bodri/smuk/hardware/pcb/production/bom.csv

Designator | Footprint | Quantity | Value | LCSC Part #
C1, C2, C4, C5 | 0805 | 4 | 100nF
C10, C9 | 0805 | 2 | 100n
C11, C12 | C_Elec_10x10.2 | 2 | 100u
C13, C14 | CP_EIA-6032-28_Kemet-C | 2 | 10u
C6 | 1206 | 1 | 15p
C7 | 0805 | 1 | 15p
C8 | 1206 | 1 | 100n
D1, D4 | SOT-23 | 2 | MMBD4148SE
D2, D3 | D_SOD-123 | 2 | 1N4148W
D5, D6 | D_SMC | 2 | SK84
HS1 | Heatsink_Fischer_SK96-84SA_2Fixations | 1 | Heatsink_Pad
J1, J3, J4 | Molex_KK-396_A-41791-0003_1x03_P3.96mm_Vertical | 3 | Conn_01x03
J2 | PinHeader_1x09_P2.54mm_Horizontal | 1 | Conn_01x09_Pin
Q1 | SOT-23 | 1 | MMBTA06
Q2 | SOT-23 | 1 | MMBTA56
Q3 | TO-220-3_Vertical | 1 | TIP42
Q4 | TO-220-3_Vertical | 1 | TIP41
R1 | 0805 | 1 | 2K74
R10, R9 | 1206 | 2 | 1K
R11, R12, R2, R5 | 0805 | 4 | 10K
R13 | 0805 | 1 | 1K
R14 | 0805 | 1 | 5K11
R15, R16 | 0805 | 2 | 20
R17, R18 | 0805 | 2 | 200
R19, R22 | 0805 | 2 | 300
R20, R21 | 2512 | 2 | 1K
R23, R24 | 0805 | 2 | 100
R25, R26 | 2512 | 2 | 1
R3 | 0805 | 1 | 15K
R4 | 0805 | 1 | 24K9
R7 | 0805 | 1 | 100K
R8 | 0805 | 1 | 50K
TP1 | TestPoint_Loop_D1.80mm_Drill1.0mm_Beaded | 1 | GND
TP2 | TestPoint_Loop_D1.80mm_Drill1.0mm_Beaded | 1 | FORCE
U1 | TSSOP-14_4.4x5mm_P0.65mm | 1 | OPA4992
U2 | SOT-23 | 1 | TL431DBZ
U3 | TSSOP-16_4.4x5mm_P0.65mm | 1 | CD4053B
U4, U5 | SOIC-8_3.9x4.9mm_P1.27mm | 2 | LM334M
