bodri/smuk/hardware/sense/production/bom.csv

Designator | Footprint | Quantity | Value | LCSC Part #
C1, C2 | C_Elec_10x10.2 | 2 | 100u
C10, C11, C12, C13, C17, C21, C30, C31, C33, C34, C35, C36, C37, C38, C41, C44, C48, C5, C50, C52, C54, C55, C56, C6, C64, C65, C7, C8, C9 | 0603 | 29 | 100n
C14, C19, C22 | 0603 | 3 | 10n
C15, C16, C70, C71 | 1210 | 4 | 10u
C18, C23, C39, C40, C45, C47, C49 | 0603 | 7 | 1u
C20 | 1206 | 1 | 10u
C24, C25 | 0805 | 2 | 10u
C26, C29 | 0603 | 2 | 12p
C27, C32 | 0603 | 2 | 2.2u
C28 | 0603 | 1 | 4.7u
C3 | CP_EIA-6032-28_Kemet-C | 1 | 22u
C4 | 0603 | 1 | 680p
C42, C43, C46 | 0603 | 3 | 1n
C51 | 0603 | 1 | 220n
C53 | 0603 | 1 | 10u
C57, C58 | 0603 | 2 | 100p
C59, C60 | 0603 | 2 | 500p
C61, C62 | 0603 | 2 | 100nF
C63 | 0603 | 1 | 15p
C66 | 1206 | 1 | 15p
C67, C68, C69 | 1206 | 3 | 100n
D1 | SOT-23 | 1 | BAV70
D10, D11, D7, D8 | D_SOD-123 | 4 | 1N4148W
D12, D9 | SOT-23 | 2 | MMBD4148SE
D13, D14 | D_SMC | 2 | SK84
D2 | D_MiniMELF | 1 | BZV55B10
D3, D4, D5, D6 | 0603 | 4 | LED
FB1 | 0603 | 1 | 1K @ 100MHz
FB2, FB3 | 0603 | 2 | FerriteBead_Small
HS1 | Heatsink_Fischer_SK96-84SA_2Fixations | 1 | Heatsink_Pad
J1 | Molex_KK-396_A-41791-0003_1x03_P3.96mm_Vertical | 1 | Conn_01x03_Pin
J2 | Molex_KK-396_A-41791-0005_1x05_P3.96mm_Vertical | 1 | Conn_01x05_Male
J3 | Molex_KK-254_AE-6410-05A_1x05_P2.54mm_Vertical | 1 | Conn_01x05_Pin
JP1, JP2, JP3, JP4, JP7, JP8 | TestPoint_2Pads_Pitch2.54mm_Drill0.8mm | 6 | Jumper_2_Open
K1 | Relay_DPDT_Panasonic_DS2_S | 1 | DS2-S
K2 | Relay_StandexMeder_DIP_LowProfile | 1 | D32A2110
Q1 | SOT-23 | 1 | BC847
Q10, Q14, Q18, Q2, Q3, Q4 | SOT-23 | 6 | 2N7002
Q11, Q12, Q13, Q5, Q6, Q7 | SOT-23 | 6 | ZVN4106F
Q15 | SOT-23 | 1 | BC850
Q16, Q20 | SOT-23 | 2 | MMBTA56
Q17, Q19 | SOT-23 | 2 | MMBTA06
Q21 | TO-220-3_Vertical | 1 | TIP42
Q22 | TO-220-3_Vertical | 1 | TIP41
Q8, Q9 | TSSOP-8_4.4x3mm_P0.65mm | 2 | Si6966DQ
R1 | 0603 | 1 | 2K2
R10, R11, R12, R13, R14, R15, R22, R24, R3, R4 | 0603 | 10 | 1M
R16, R32, R45, R57, R79 | 0603 | 5 | 2K
R17, R18, R19, R20, R21, R35, R98 | 0603 | 7 | 100K
R2 | 1206 | 1 | 330
R23 | 1206 | 1 | 1K8
R25 | 1206 | 1 | 180
R26 | 1206 | 1 | 18
R27 | 1206 | 1 | 1R8
R28, R30, R33, R34, R41, R42, R43, R44, R46, R61, R71, R72, R73, R74, R82 | 0603 | 15 | 1K
R29 | Littelfuse L4CL1206 | 1 | 0R1
R31, R39, R56 | 0603 | 3 | 15K
R36 | 1206 | 1 | 10M
R37, R40, R47, R48, R55, R63, R64, R65, R66, R67, R68, R69, R70, R75, R76, R81 | 0603 | 16 | 10K
R38 | 0603 | 1 | 2K49
R49 | 0603 | 1 | 35K7
R5, R6, R7, R8, R9 | 0603 | 5 | 330K
R50 | 0603 | 1 | 43K2
R51 | 0603 | 1 | 680R
R52, R53, R54 | 0603 | 3 | 680
R58 | 1206 | 1 | 0
R59, R60, R62 | 0603 | 3 | 49R9
R77, R78 | 1206 | 2 | 1K
R80 | 0603 | 1 | 121
R83 | 1206 | 1 | 5K11
R84, R85 | 1206 | 2 | 2K
R86, R87 | 0805 | 2 | 20
R88, R89 | 0805 | 2 | 200
R90, R93 | 0805 | 2 | 300
R91, R92 | 2512 | 2 | 1K
R94, R95 | 0805 | 2 | 100
R96, R97 | 2512 | 2 | 1
TP1 | TestPoint_Loop_D1.80mm_Drill1.0mm_Beaded | 1 | GND
TP2 | TestPoint_Pad_D1.5mm | 1 | Current meas
TP3 | TestPoint_Pad_D1.5mm | 1 | Voltage meas
TP4 | TestPoint_Pad_D1.5mm | 1 | +1V5
TP5 | TestPoint_Pad_D1.5mm | 1 | +3V
TP6 | TestPoint_Loop_D1.80mm_Drill1.0mm_Beaded | 1 | FORCEI
TP7 | TestPoint_Loop_D1.80mm_Drill1.0mm_Beaded | 1 | FORCEV
U1 | TO-263-3_TabPin2 | 1 | uA7805
U10 | TSSOP-16_4.4x5mm_P0.65mm | 1 | AD5686
U11 | TSSOP-20_4.4x6.5mm_P0.65mm | 1 | ADS131M03xPW
U12, U14 | TSSOP-14_4.4x5mm_P0.65mm | 2 | OPA4992
U13 | SOT-23-5 | 1 | REF2030
U15 | TSSOP-16_4.4x5mm_P0.65mm | 1 | CD4053B
U16, U17 | SOIC-8_3.9x4.9mm_P1.27mm | 2 | LM334M
U2 | TSSOP-14_4.4x5mm_P0.65mm | 1 | OPA4189
U3, U5 | SOIC-8_3.9x4.9mm_P1.27mm | 2 | OPA140
U4 | MSOP-8_3x3mm_P0.65mm | 1 | ADG5419BRMZ
U6 | Texas_S-PVSON-N10_ThermalVias | 1 | TPS7A39
U7 | SOT-23-5 | 1 | TPS7A2033DBV
U8 | SOIC-16W_7.5x10.3mm_P1.27mm | 1 | ISO7341C
U9 | QFN-48-1EP_7x7mm_P0.5mm_EP5.6x5.6mm | 1 | STM32H503CBUx
Y1 | Crystal_SMD_SeikoEpson_FA238-4Pin_3.2x2.5mm | 1 | 16MHz
Y2 | CDFN-4_2.5x3.2mm_P2.1mm | 1 | DSC100X
