bodri/smuk/hardware/sense/sense.kicad_pcb

## KiCad design hardware/sense/sense.kicad_pcb (2026-11-12)

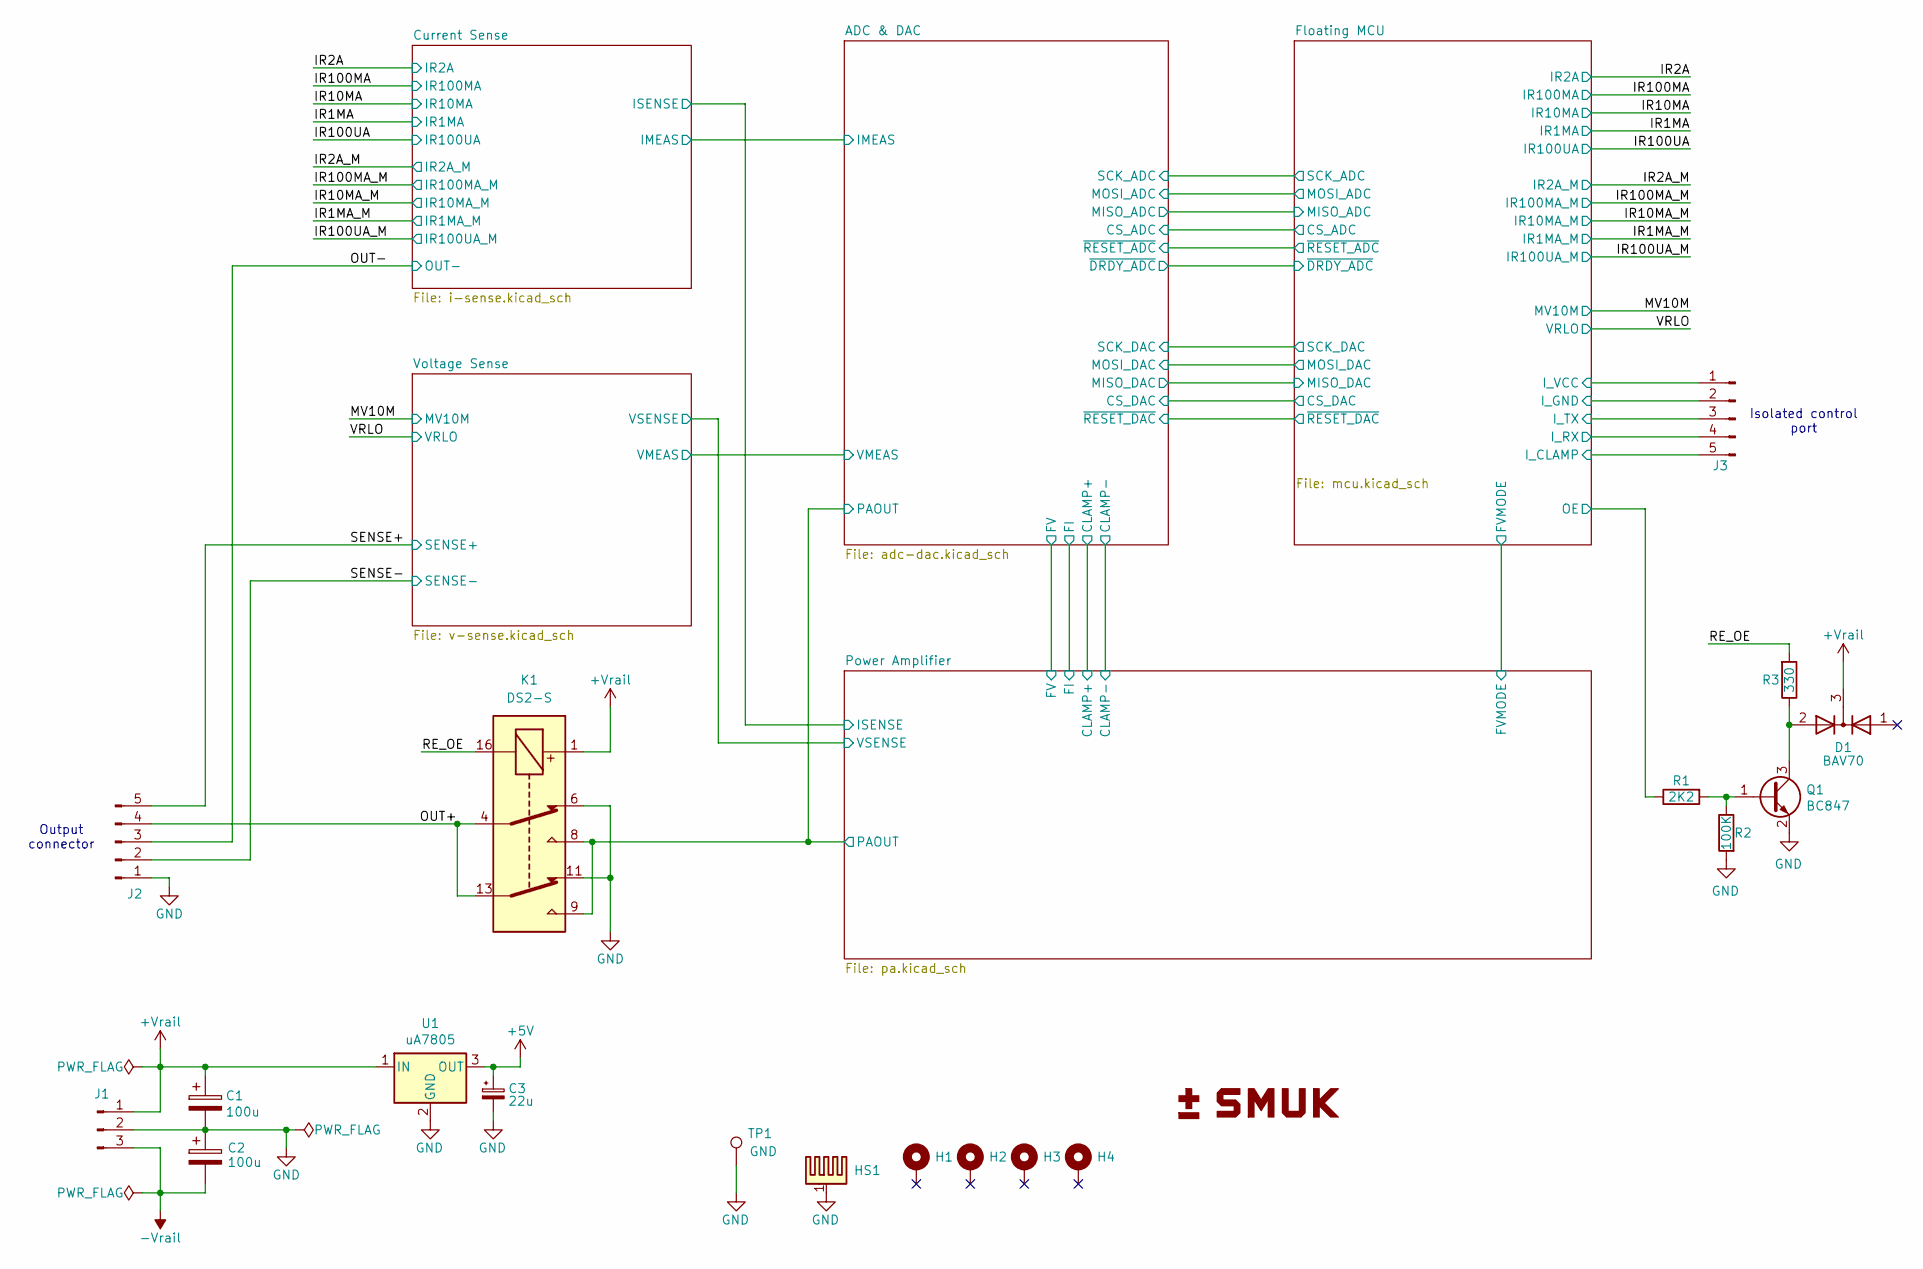
[picture p8: schematic sense.kicad_sch, SMUK (SMU by Kapuki)]

Parts:
C1, C2: 100u; C_Elec_10x10.2
C3: 22u; CP_EIA-6032-28_Kemet-C
D1: BAV70; SOT-23
H1, H2, H3, H4: MountingHole_Pad_MP; MountingHole_3.2mm_M3_Pad_Via
HS1: Heatsink_Pad; Heatsink_Fischer_SK96-84SA_2Fixations
J1: Conn_01x03_Pin; Molex_KK-396_A-41791-0003_1x03_P3.96mm_Vertical
J2: Conn_01x05_Male; Molex_KK-396_A-41791-0005_1x05_P3.96mm_Vertical
J3: Conn_01x05_Pin; Molex_KK-254_AE-6410-05A_1x05_P2.54mm_Vertical
K1: DS2-S; Relay_DPDT_Panasonic_DS2_S
Q1: BC847; SOT-23
R1: 2K2; R_0603_1608Metric
R2: 100K; R_0603_1608Metric
R3: 330; R_1206_3216Metric
TP1: GND; TestPoint_Loop_D1.80mm_Drill1.0mm_Beaded
U1: uA7805; TO-263-3_TabPin2

Connections:
+5V: C3.1, U1.3 (OUT); also elsewhere on the board
+Vrail: C1.1, D1.3 (K), J1.1, K1.1, U1.1 (IN); also elsewhere on the board
-Vrail: C2.2, J1.3; also elsewhere on the board
/ADC & DAC/PAOUT: K1.8, K1.9; also elsewhere on the board
/Floating MCU/I_CLAMP: J3.5; also elsewhere on the board
/Floating MCU/I_GND: J3.2; also elsewhere on the board
/Floating MCU/I_RX: J3.4; also elsewhere on the board
/Floating MCU/I_TX: J3.3; also elsewhere on the board
/Floating MCU/I_VCC: J3.1; also elsewhere on the board
/Floating MCU/OE: R1.1; also elsewhere on the board
/OUT+: J2.4, K1.4, K1.13
/OUT-: J2.3; also elsewhere on the board
/RE_OE: K1.16, R3.2
/SENSE+: J2.5; also elsewhere on the board
/SENSE-: J2.2; also elsewhere on the board
GND: C1.2, C2.1, C3.2, HS1.1, J1.2, J2.1, K1.6, K1.11, Q1.2 (E), R2.2, TP1.1 (1_1), U1.2 (GND); also elsewhere on the board
unnamed: Q1.1 (B), R1.2, R2.1
unnamed: D1.2 (A), Q1.3 (C), R3.1

Notes on the sheet:
Isolated control port
Output connector

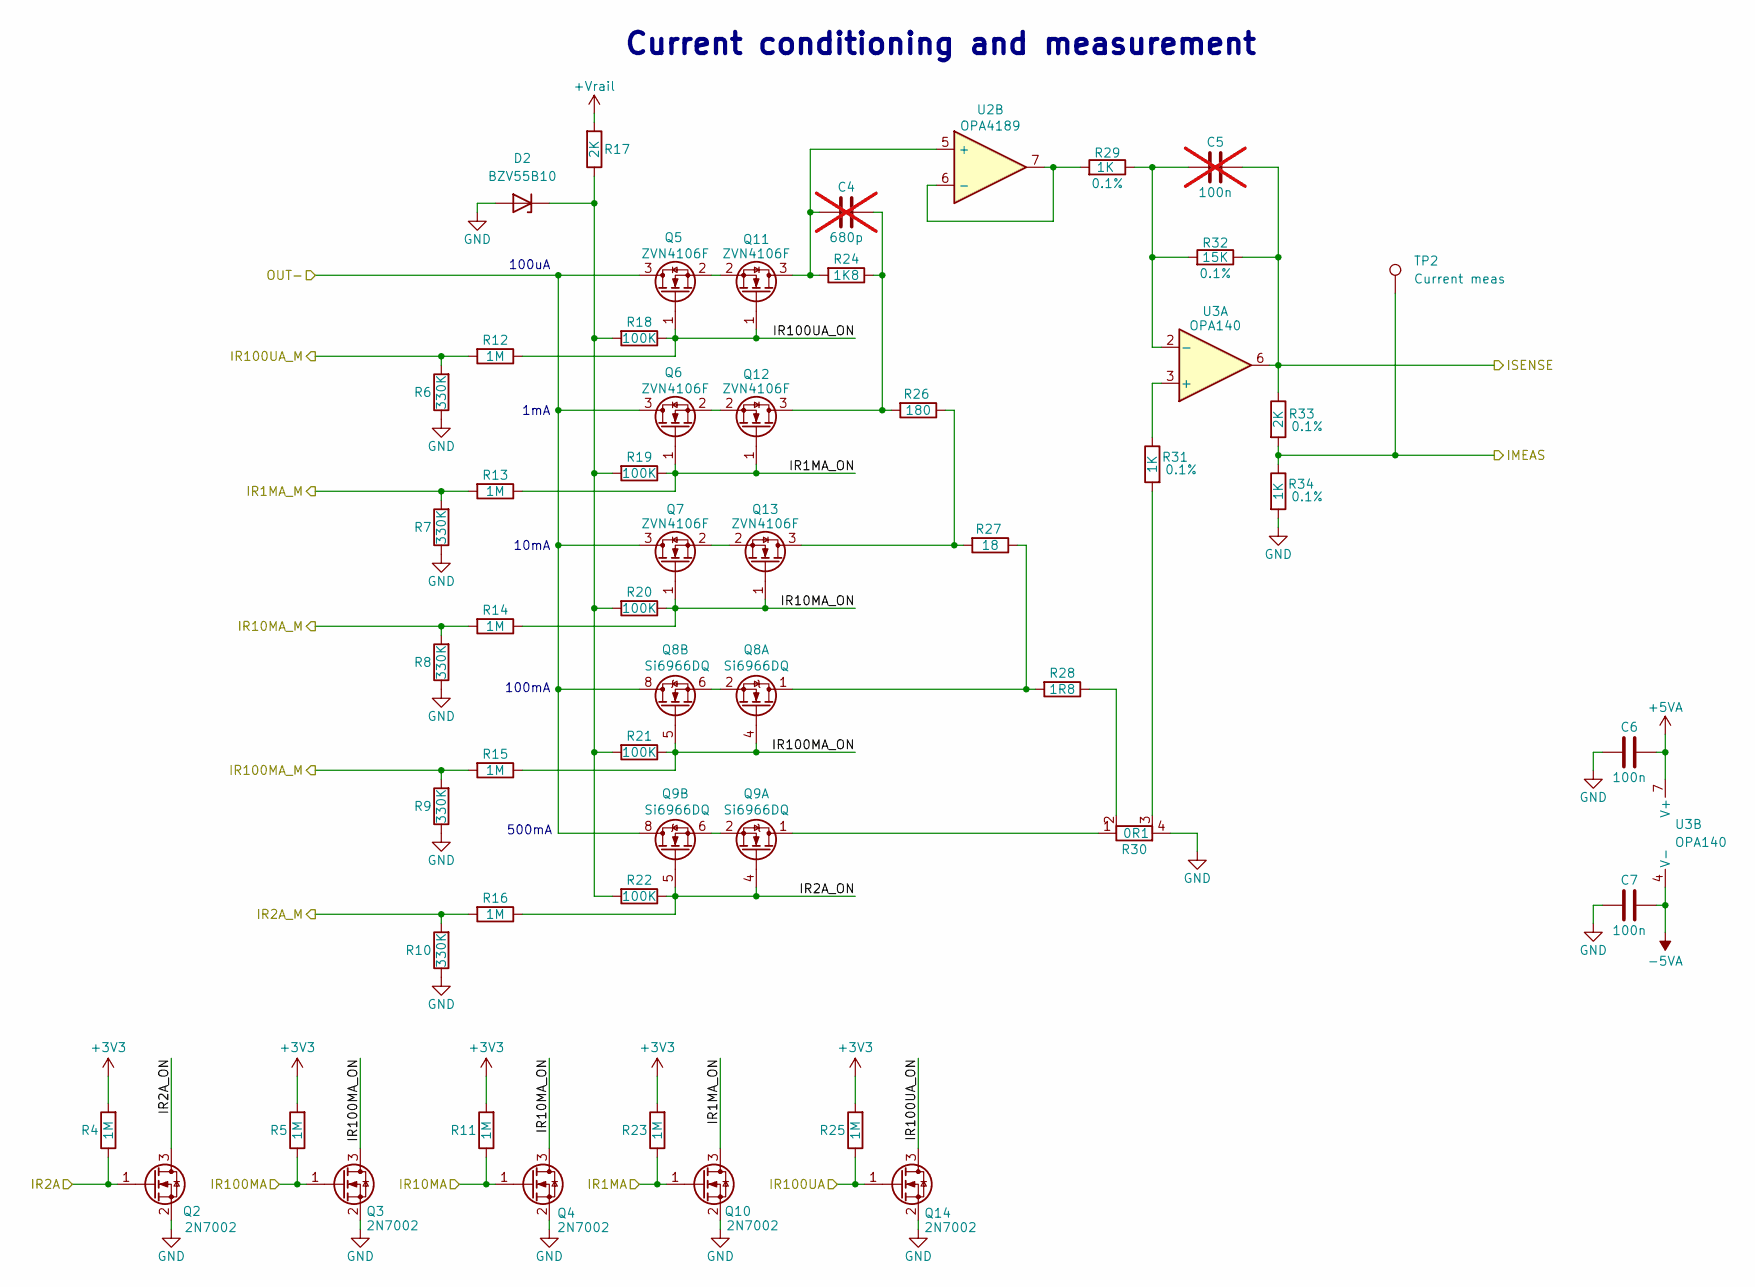
[picture p9: schematic i-sense.kicad_sch, SMUK (SMU by Kapuki)]

Parts:
C4: 680p; C_0603_1608Metric; not fitted
C5: 100n; C_0603_1608Metric; not fitted
C6, C7: 100n; C_0603_1608Metric
D2: BZV55B10; D_MiniMELF
Q2, Q3, Q4, Q10, Q14: 2N7002; SOT-23
Q5, Q6, Q7, Q11, Q12, Q13: ZVN4106F; SOT-23
Q8, Q9: Si6966DQ; TSSOP-8_4.4x3mm_P0.65mm
R4, R5, R11, R12, R13, R14, R15, R16, R23, R25: 1M; R_0603_1608Metric
R6, R7, R8, R9, R10: 330K; R_0603_1608Metric
R17, R33: 2K; R_0603_1608Metric
R18, R19, R20, R21, R22: 100K; R_0603_1608Metric
R24: 1K8; R_1206_3216Metric
R26: 180; R_1206_3216Metric
R27: 18; R_1206_3216Metric
R28: 1R8; R_1206_3216Metric
R29, R31, R34: 1K; R_0603_1608Metric
R30: 0R1; Littelfuse L4CL1206
R32: 15K; R_0603_1608Metric
TP2: Current meas; TestPoint_Pad_D1.5mm
U2: OPA4189; TSSOP-14_4.4x5mm_P0.65mm
U3: OPA140; SOIC-8_3.9x4.9mm_P1.27mm

Connections:
+3V3: R4.2, R5.2, R11.2, R23.2, R25.2; also elsewhere on the board
+5VA: C6.1, U3.7 (V+); also elsewhere on the board
+Vrail: R17.2; also elsewhere on the board
-5VA: C7.1, U3.4 (V-); also elsewhere on the board
/ADC & DAC/IMEAS: R33.2, R34.1, TP2.1 (1_1); also elsewhere on the board
/Current Sense/IR1MA_ON: Q6.1 (G), Q10.3 (D), Q12.1 (G), R13.1, R19.1
/Current Sense/IR2A_ON: Q2.3 (D), Q9.4 (G1), Q9.5 (G2), R16.1, R22.1
/Current Sense/IR10MA_ON: Q4.3 (D), Q7.1 (G), Q13.1 (G), R14.1, R20.1
/Current Sense/IR100MA_ON: Q3.3 (D), Q8.4 (G1), Q8.5 (G2), R15.1, R21.1
/Current Sense/IR100UA_ON: Q5.1 (G), Q11.1 (G), Q14.3 (D), R12.1, R18.1
/Current Sense/ISENSE: C5.1, R32.1, R33.1, U3.6; also elsewhere on the board
/IR1MA: Q10.1 (G), R23.1; also elsewhere on the board
/IR1MA_M: R7.2, R13.2; also elsewhere on the board
/IR2A: Q2.1 (G), R4.1; also elsewhere on the board
/IR2A_M: R10.2, R16.2; also elsewhere on the board
/IR10MA: Q4.1 (G), R11.1; also elsewhere on the board
/IR10MA_M: R8.2, R14.2; also elsewhere on the board
/IR100MA: Q3.1 (G), R5.1; also elsewhere on the board
/IR100MA_M: R9.2, R15.2; also elsewhere on the board
/IR100UA: Q14.1 (G), R25.1; also elsewhere on the board
/IR100UA_M: R6.2, R12.2; also elsewhere on the board
/OUT-: Q5.3 (D), Q6.3 (D), Q7.3 (D), Q8.8 (D2), Q9.8 (D2); also elsewhere on the board
GND: C6.2, C7.2, D2.2 (A), Q2.2 (S), Q3.2 (S), Q4.2 (S), Q10.2 (S), Q14.2 (S), R6.1, R7.1, R8.1, R9.1, R10.1, R30.4, R34.2; also elsewhere on the board
unnamed: D2.1 (K), R17.1, R18.2, R19.2, R20.2, R21.2, R22.2
unnamed: Q8.1 (D1), R27.1, R28.2
unnamed: Q8.2 (S1), Q8.3 (S1), Q8.6 (S2), Q8.7 (S2)
unnamed: Q9.1 (D1), R30.1
unnamed: Q9.2 (S1), Q9.3 (S1), Q9.6 (S2), Q9.7 (S2)
unnamed: C4.2, Q11.3 (D), R24.2, U2.5 (+)
unnamed: Q5.2 (S), Q11.2 (S)
unnamed: C4.1, Q12.3 (D), R24.1, R26.2
unnamed: Q6.2 (S), Q12.2 (S)
unnamed: Q13.3 (D), R26.1, R27.2
unnamed: Q7.2 (S), Q13.2 (S)
unnamed: R28.1, R30.2
unnamed: R30.3, R31.2
unnamed: R29.2, U2.6 (-), U2.7
unnamed: R31.1, U3.3 (+)
unnamed: C5.2, R29.1, R32.2, U3.2 (-)

Notes on the sheet:
100mA
100uA
1mA
500mA
10mA
Current conditioning and measurement

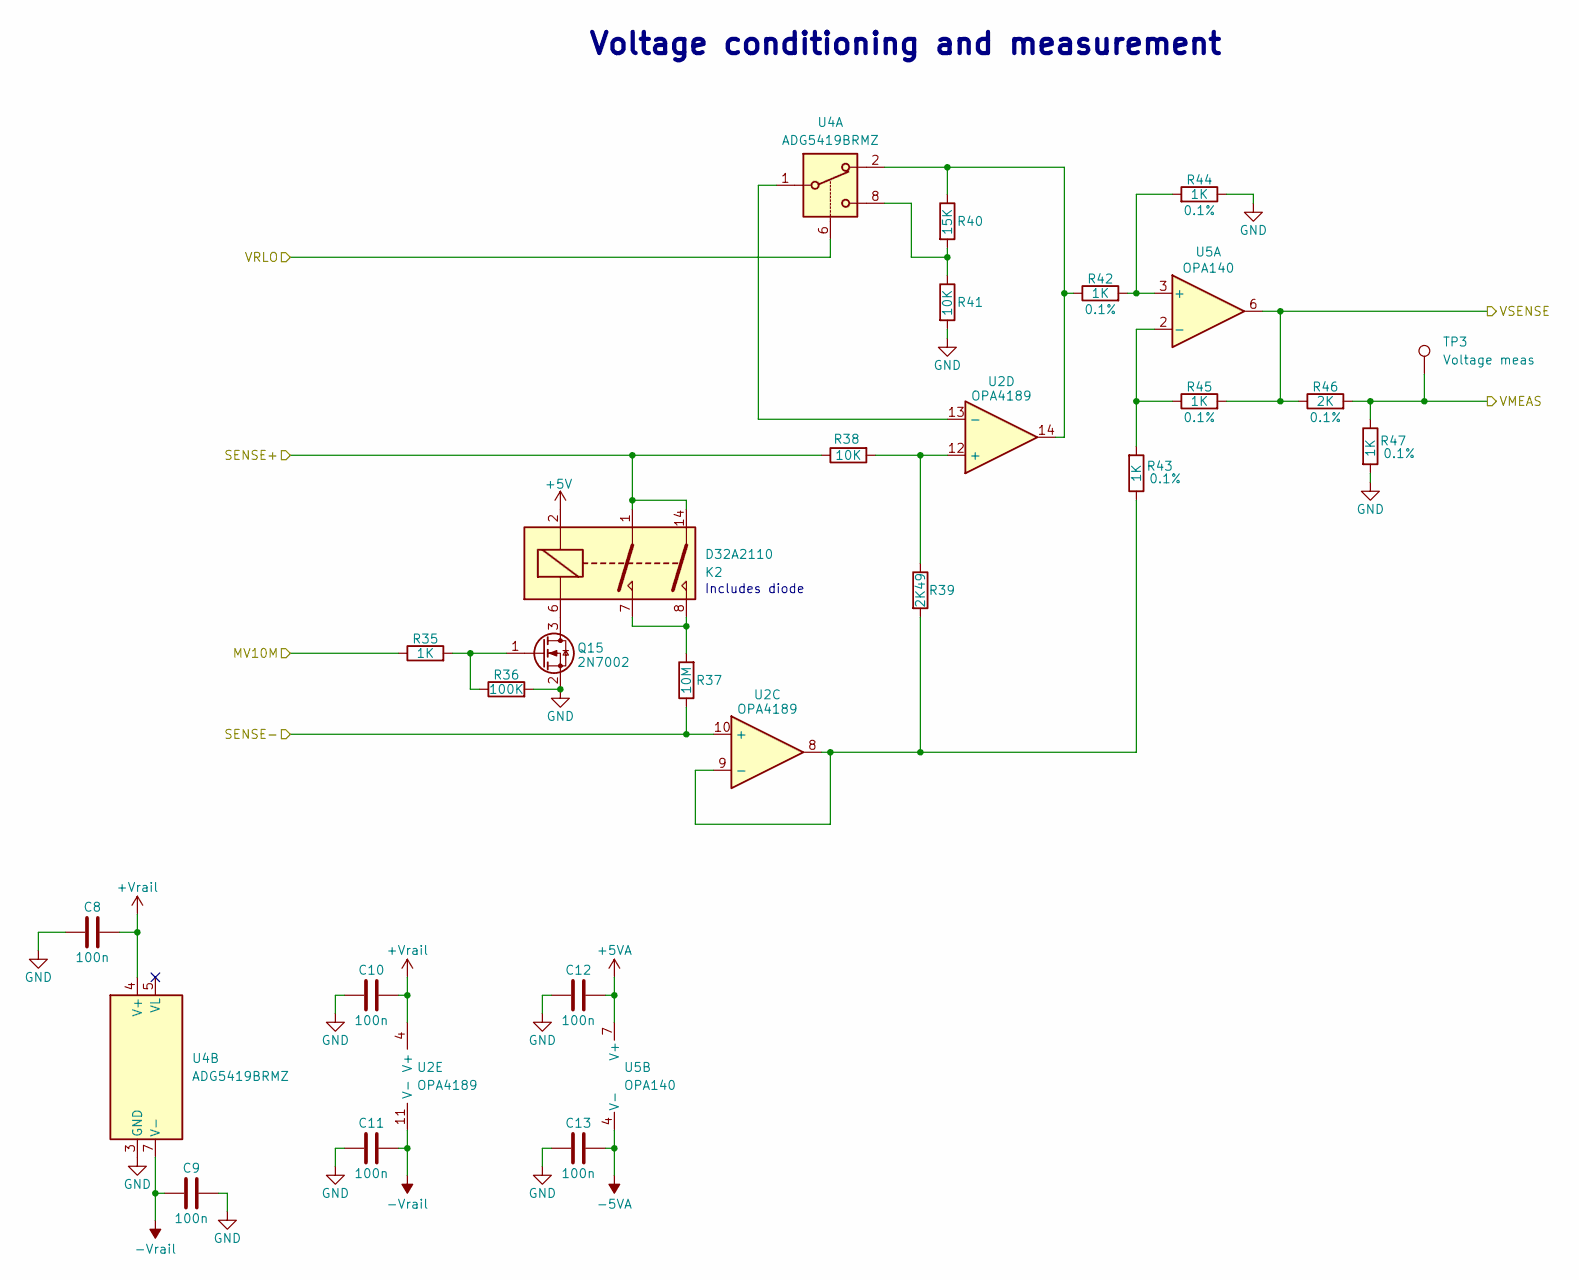
[picture p10: schematic v-sense.kicad_sch, SMUK (SMU by Kapuki)]

Parts:
C8, C9, C10, C11, C12, C13: 100n; C_0603_1608Metric
K2: D32A2110; Relay_StandexMeder_DIP_LowProfile
Q15: 2N7002; SOT-23
R35, R42, R43, R44, R45, R47: 1K; R_0603_1608Metric
R36: 100K; R_0603_1608Metric
R37: 10M; R_1206_3216Metric
R38, R41: 10K; R_0603_1608Metric
R39: 2K49; R_0603_1608Metric
R40: 15K; R_0603_1608Metric
R46: 2K; R_0603_1608Metric
TP3: Voltage meas; TestPoint_Pad_D1.5mm
U2: OPA4189; TSSOP-14_4.4x5mm_P0.65mm
U4: ADG5419BRMZ; MSOP-8_3x3mm_P0.65mm
U5: OPA140; SOIC-8_3.9x4.9mm_P1.27mm

Connections:
+5V: K2.2; also elsewhere on the board
+5VA: C12.1, U5.7 (V+); also elsewhere on the board
+Vrail: C8.1, C10.1, U2.4 (V+), U4.4 (V+); also elsewhere on the board
-5VA: C13.1, U5.4 (V-); also elsewhere on the board
-Vrail: C9.1, C11.1, U2.11 (V-), U4.7 (V-); also elsewhere on the board
/ADC & DAC/VMEAS: R46.2, R47.1, TP3.1 (1_1); also elsewhere on the board
/MV10M: R35.1; also elsewhere on the board
/Power Amplifier/VSENSE: R45.2, R46.1, U5.6; also elsewhere on the board
/SENSE+: K2.1, K2.14, R38.1; also elsewhere on the board
/SENSE-: R37.1, U2.10 (+); also elsewhere on the board
/VRLO: U4.6; also elsewhere on the board
GND: C8.2, C9.2, C10.2, C11.2, C12.2, C13.2, Q15.2 (S), R36.2, R41.2, R44.1, R47.2, U4.3 (GND); also elsewhere on the board
unnamed: K2.7, K2.8, R37.2
unnamed: K2.6, Q15.3 (D)
unnamed: Q15.1 (G), R35.2, R36.1
unnamed: R40.1, R42.1, U2.14, U4.2
unnamed: R40.2, R41.1, U4.8
unnamed: R39.2, R43.1, U2.8, U2.9 (-)
unnamed: R38.2, R39.1, U2.12 (+)
unnamed: U2.13 (-), U4.1
unnamed: R42.2, R44.2, U5.3 (+)
unnamed: R43.2, R45.1, U5.2 (-)

Notes on the sheet:
Voltage conditioning and measurement
Includes diode

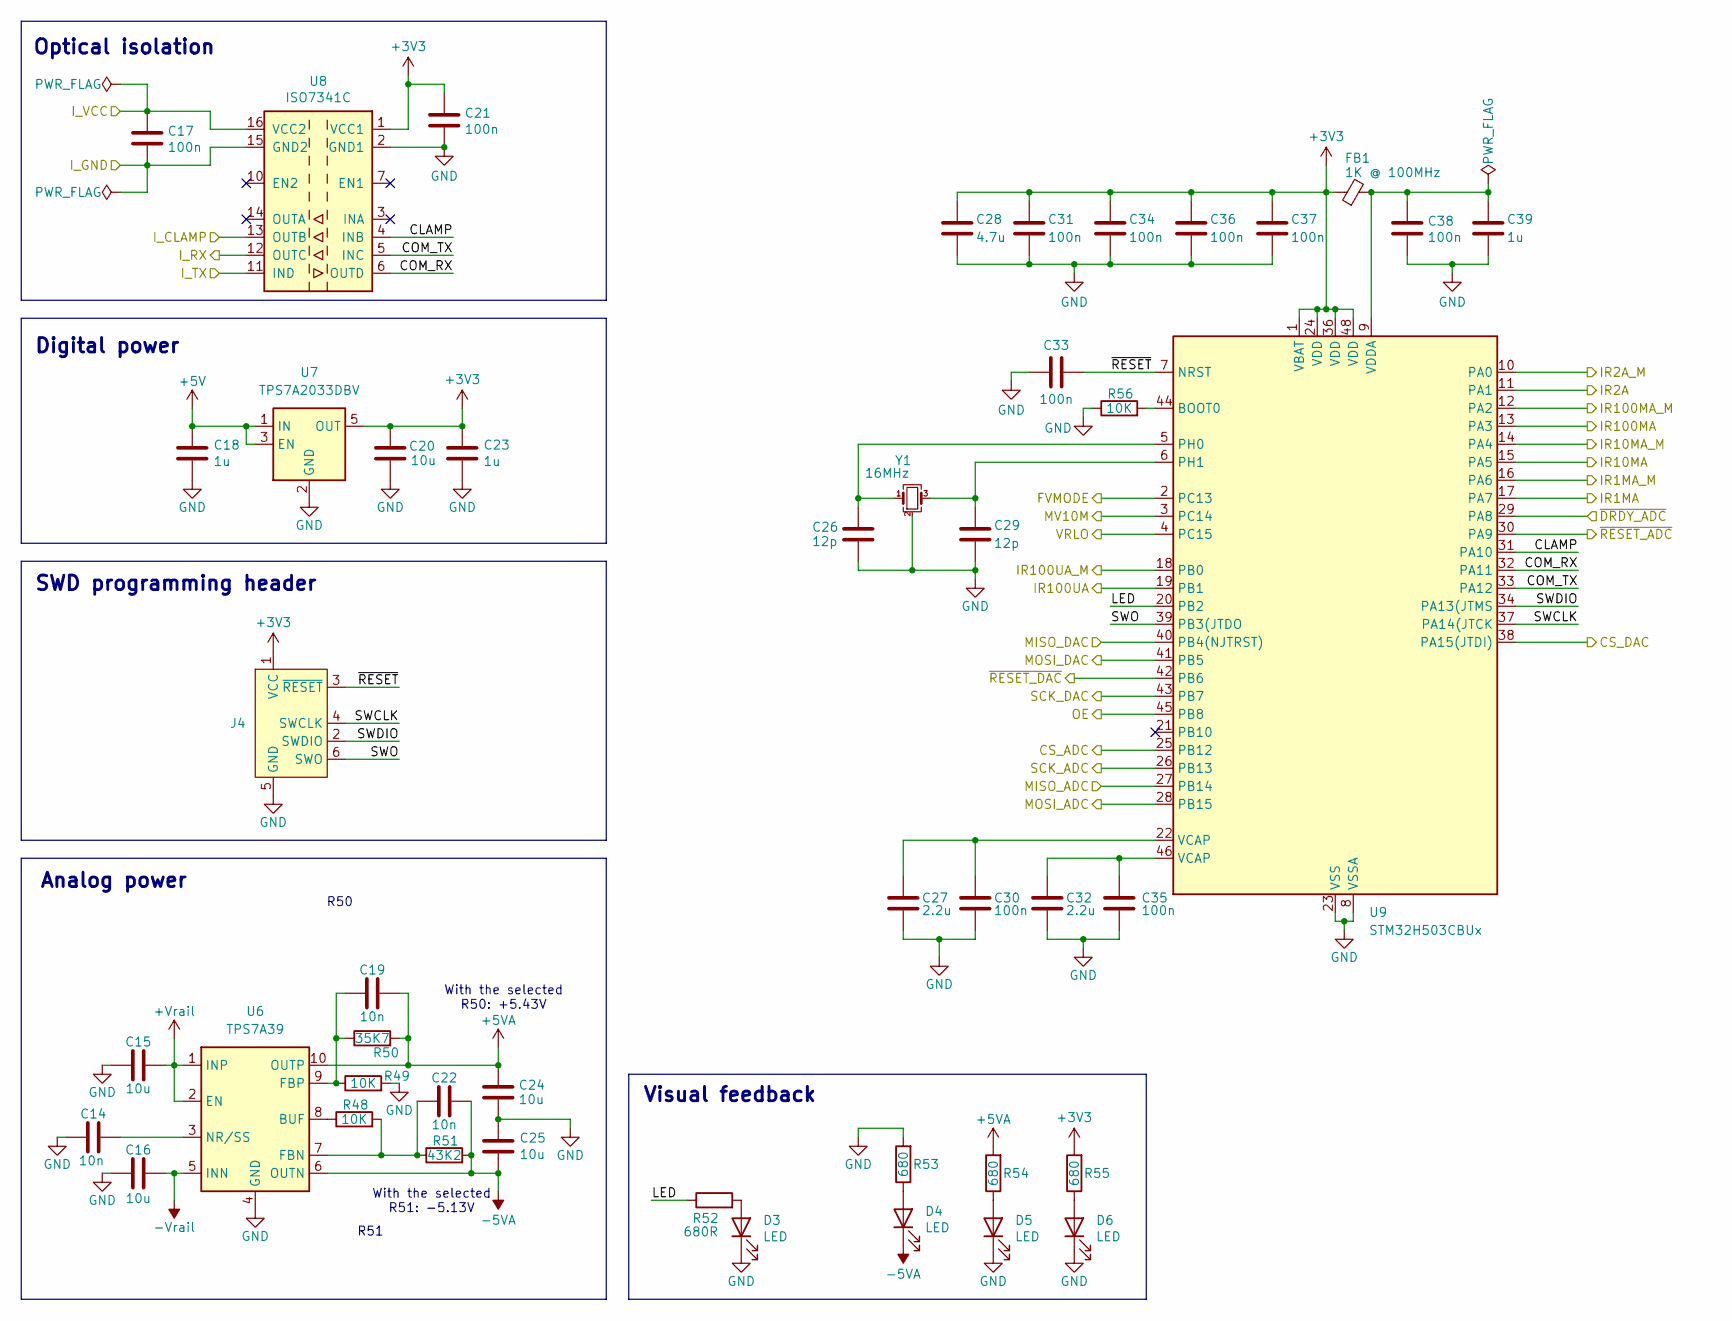
[picture p11: schematic mcu.kicad_sch, SMUK (SMU by Kapuki)]

Parts:
C14, C19, C22: 10n; C_0603_1608Metric
C15, C16: 10u; C_1210_3225Metric
C17, C21, C30, C31, C33, C34, C35, C36, C37, C38: 100n; C_0603_1608Metric
C18, C23, C39: 1u; C_0603_1608Metric
C20: 10u; C_1206_3216Metric
C24, C25: 10u; C_0805_2012Metric
C26, C29: 12p; C_0603_1608Metric
C27, C32: 2.2u; C_0603_1608Metric
C28: 4.7u; C_0603_1608Metric
D3, D4, D5, D6: LED; LED_0603_1608Metric
FB1: 1K @ 100MHz; L_0603_1608Metric
J4: Tag Connector; Tag-Connect_TC2030-IDC-NL_2x03_P1.27mm_Vertical
R48, R49, R56: 10K; R_0603_1608Metric
R50: 35K7; R_0603_1608Metric
R51: 43K2; R_0603_1608Metric
R52: 680R; R_0603_1608Metric
R53, R54, R55: 680; R_0603_1608Metric
U6: TPS7A39; Texas_S-PVSON-N10_ThermalVias
U7: TPS7A2033DBV; SOT-23-5
U8: ISO7341C; SOIC-16W_7.5x10.3mm_P1.27mm
U9: STM32H503CBUx; QFN-48-1EP_7x7mm_P0.5mm_EP5.6x5.6mm
Y1: 16MHz; Crystal_SMD_SeikoEpson_FA238-4Pin_3.2x2.5mm

Connections:
+3V3: C20.1, C21.1, C23.1, C28.1, C31.1, C34.1, C36.1, C37.1, FB1.1, J4.1 (VCC), R55.2, U7.5 (OUT), U8.1 (VCC1), U9.1 (VBAT), U9.24 (VDD), U9.36 (VDD), U9.48 (VDD); also elsewhere on the board
+5V: C18.1, U7.1 (IN), U7.3 (EN); also elsewhere on the board
+5VA: C19.1, C24.1, R50.2, R54.2, U6.10 (OUTP); also elsewhere on the board
+Vrail: C15.1, U6.1 (INP), U6.2 (EN); also elsewhere on the board
-5VA: C22.1, C25.2, D4.1 (K), R51.2, U6.6 (OUTN); also elsewhere on the board
-Vrail: C16.1, U6.5 (INN); also elsewhere on the board
/ADC & DAC/CS_ADC: U9.25 (PB12); also elsewhere on the board
/ADC & DAC/CS_DAC: U9.38 (PA15(JTDI)); also elsewhere on the board
/ADC & DAC/MISO_ADC: U9.27 (PB14); also elsewhere on the board
/ADC & DAC/MISO_DAC: U9.40 (PB4(NJTRST)); also elsewhere on the board
/ADC & DAC/MOSI_ADC: U9.28 (PB15); also elsewhere on the board
/ADC & DAC/MOSI_DAC: U9.41 (PB5); also elsewhere on the board
/ADC & DAC/SCK_ADC: U9.26 (PB13); also elsewhere on the board
/ADC & DAC/SCK_DAC: U9.43 (PB7); also elsewhere on the board
/ADC & DAC/~DRDY_ADC: U9.29 (PA8); also elsewhere on the board
/ADC & DAC/~RESET_ADC: U9.30 (PA9); also elsewhere on the board
/ADC & DAC/~RESET_DAC: U9.42 (PB6); also elsewhere on the board
/Floating MCU/CLAMP: U8.4 (INB), U9.31 (PA10)
/Floating MCU/COM_RX: U8.6 (OUTD), U9.32 (PA11)
/Floating MCU/COM_TX: U8.5 (INC), U9.33 (PA12)
/Floating MCU/FVMODE: U9.2 (PC13); also elsewhere on the board
/Floating MCU/I_CLAMP: U8.13 (OUTB); also elsewhere on the board
/Floating MCU/I_GND: C17.2, U8.9 (GND2), U8.15 (GND2); also elsewhere on the board
/Floating MCU/I_RX: U8.12 (OUTC); also elsewhere on the board
/Floating MCU/I_TX: U8.11 (IND); also elsewhere on the board
/Floating MCU/I_VCC: C17.1, U8.16 (VCC2); also elsewhere on the board
/Floating MCU/LED: R52.1, U9.20 (PB2)
/Floating MCU/OE: U9.45 (PB8); also elsewhere on the board
/Floating MCU/SWCLK: J4.4 (SWCLK), U9.37 (PA14(JTCK)
/Floating MCU/SWDIO: J4.2 (SWDIO), U9.34 (PA13(JTMS)
/Floating MCU/SWO: J4.6 (SWO), U9.39 (PB3(JTDO)
/Floating MCU/~RESET: C33.2, J4.3 (~RESET), U9.7 (NRST)
/IR1MA: U9.17 (PA7); also elsewhere on the board
/IR1MA_M: U9.16 (PA6); also elsewhere on the board
/IR2A: U9.11 (PA1); also elsewhere on the board
/IR2A_M: U9.10 (PA0); also elsewhere on the board
/IR10MA: U9.15 (PA5); also elsewhere on the board
/IR10MA_M: U9.14 (PA4); also elsewhere on the board
/IR100MA: U9.13 (PA3); also elsewhere on the board
/IR100MA_M: U9.12 (PA2); also elsewhere on the board
/IR100UA: U9.19 (PB1); also elsewhere on the board
/IR100UA_M: U9.18 (PB0); also elsewhere on the board
/MV10M: U9.3 (PC14); also elsewhere on the board
/VRLO: U9.4 (PC15); also elsewhere on the board
GND: C14.2, C15.2, C16.2, C18.2, C20.2, C21.2, C23.2, C24.2, C25.1, C26.2, C27.2, C28.2, C29.2, C30.2, C31.2, C32.2, C33.1, C34.2, C35.2, C36.2, C37.2, C38.2, C39.2, D3.1 (K), D5.1 (K), D6.1 (K), J4.5 (GND), R49.2, R53.2, R56.1, U6.4 (GND), U6.11 (GND), U7.2 (GND), U8.2 (GND1), U8.8 (GND1), U9.8 (VSSA), U9.23 (VSS), U9.35 (VSS), U9.47 (VSS), U9.49 (VSS), Y1.2 (G), Y1.4 (G); also elsewhere on the board
unnamed: C27.1, C30.1, U9.22 (VCAP)
unnamed: C32.1, C35.1, U9.46 (VCAP)
unnamed: D3.2 (A), R52.2
unnamed: D4.2 (A), R53.1
unnamed: D5.2 (A), R54.1
unnamed: D6.2 (A), R55.1
unnamed: R48.1, U6.8 (BUF)
unnamed: C22.2, R48.2, R51.1, U6.7 (FBN)
unnamed: C19.2, R49.1, R50.1, U6.9 (FBP)
unnamed: C14.1, U6.3 (NR/SS)
unnamed: R56.2, U9.44 (BOOT0)
unnamed: C26.1, U9.5 (PH0), Y1.1
unnamed: C29.1, U9.6 (PH1), Y1.3
unnamed: C38.1, C39.1, FB1.2, U9.9 (VDDA)

Notes on the sheet:
Digital power
SWD programming header
Analog power
With the selected R50: +5.43V
Optical isolation
With the selected R51: -5.13V
R51
Visual feedback
R50

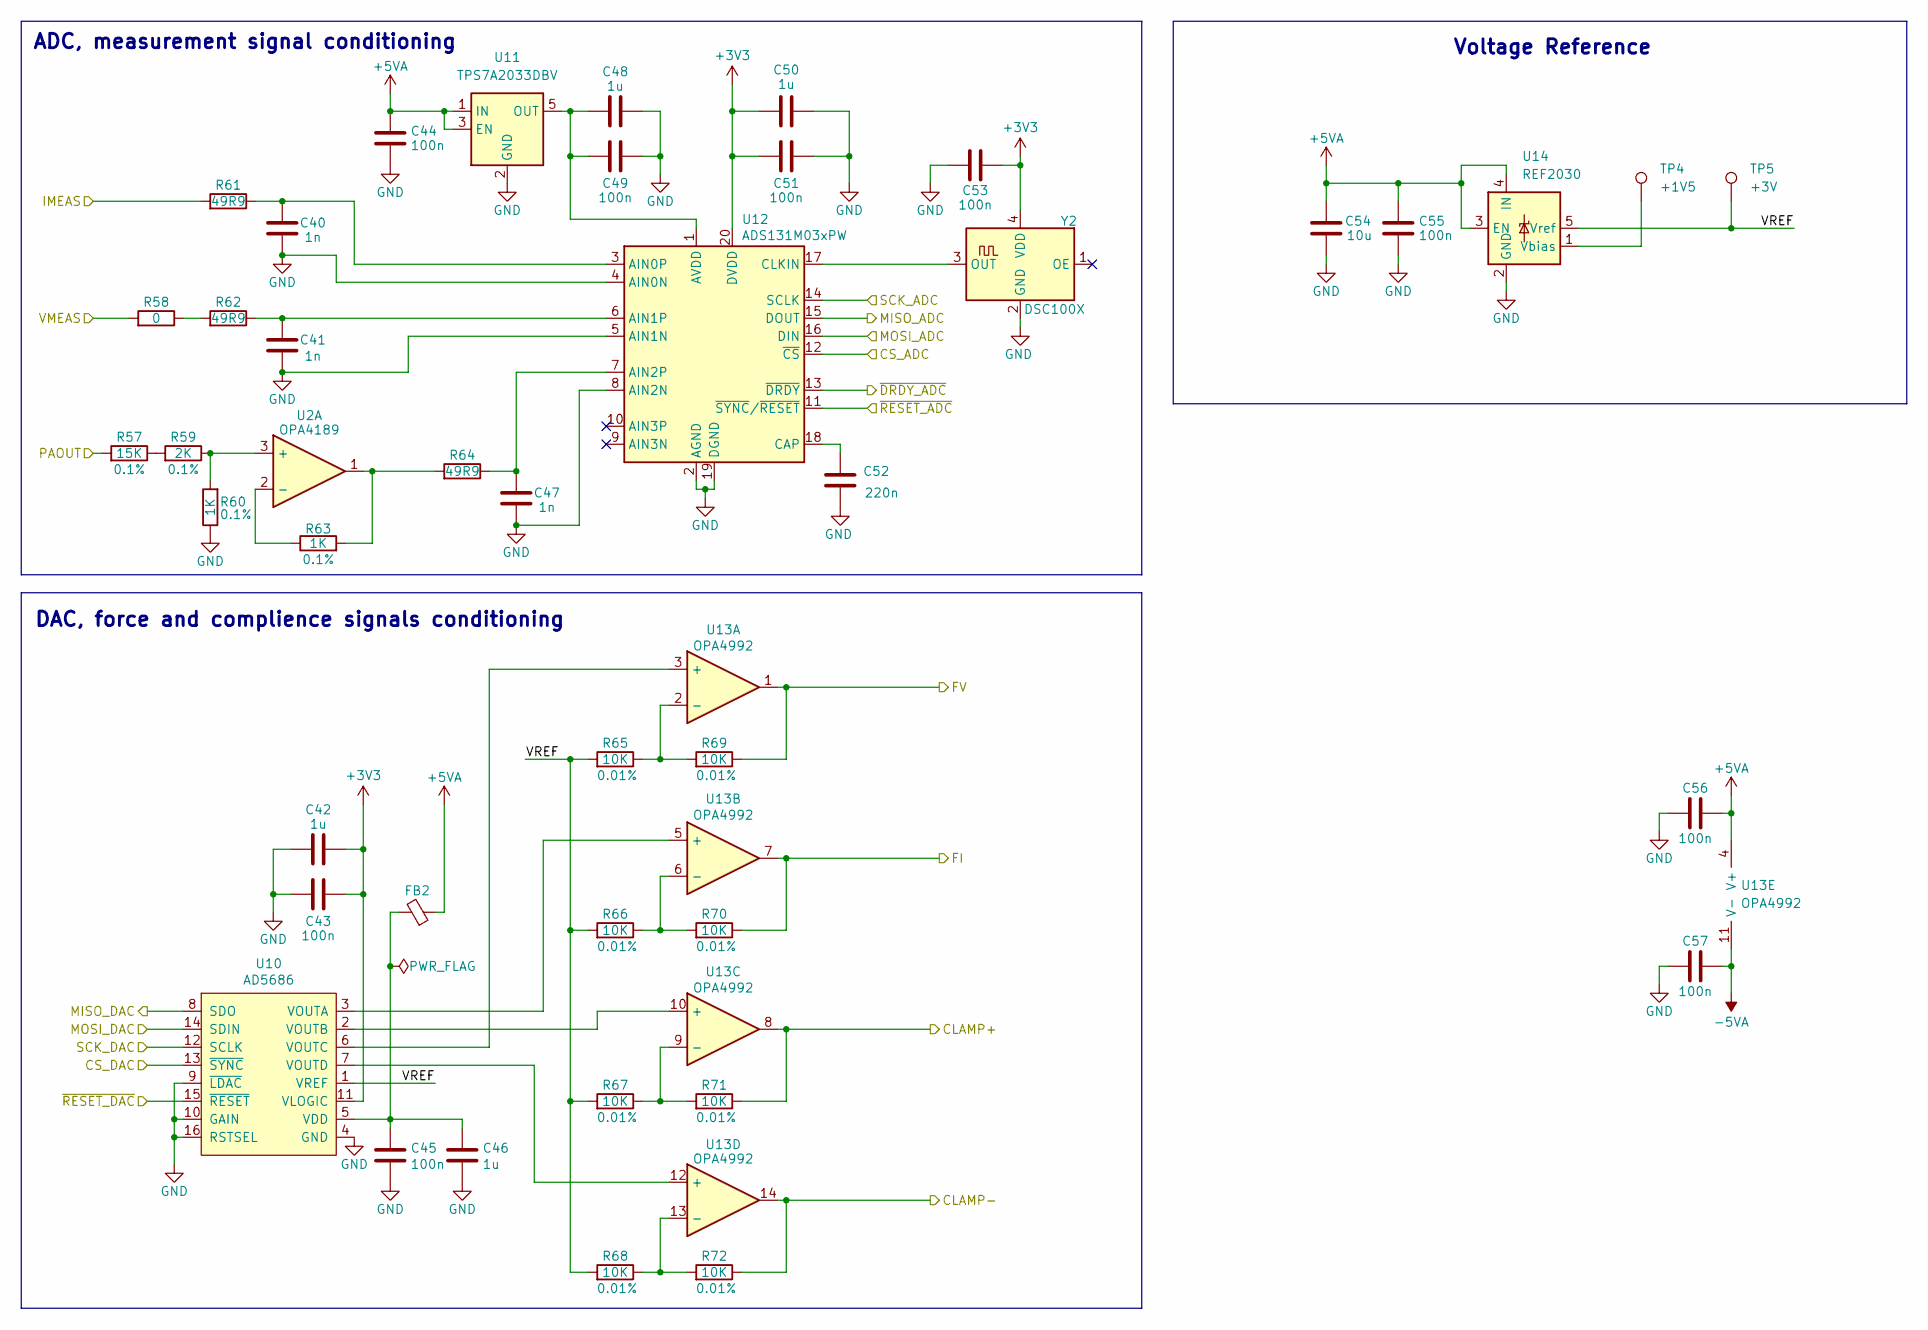
[picture p12: schematic adc-dac.kicad_sch, SMUK (SMU by Kapuki)]

Parts:
C40, C41, C47: 1n; C_0603_1608Metric
C42, C46, C48, C50: 1u; C_0603_1608Metric
C43, C44, C45, C49, C51, C53, C55, C56, C57: 100n; C_0603_1608Metric
C52: 220n; C_0603_1608Metric
C54: 10u; C_0603_1608Metric
FB2: FerriteBead_Small; L_0603_1608Metric
R57: 15K; R_0603_1608Metric
R58: 0; R_1206_3216Metric
R59: 2K; R_0603_1608Metric
R60, R63: 1K; R_0603_1608Metric
R61, R62, R64: 49R9; R_0603_1608Metric
R65, R66, R67, R68, R69, R70, R71, R72: 10K; R_0603_1608Metric
TP4: +1V5; TestPoint_Pad_D1.5mm
TP5: +3V; TestPoint_Pad_D1.5mm
U2: OPA4189; TSSOP-14_4.4x5mm_P0.65mm
U10: AD5686; TSSOP-16_4.4x5mm_P0.65mm
U11: TPS7A2033DBV; SOT-23-5
U12: ADS131M03xPW; TSSOP-20_4.4x6.5mm_P0.65mm
U13: OPA4992; TSSOP-14_4.4x5mm_P0.65mm
U14: REF2030; SOT-23-5
Y2: DSC100X; CDFN-4_2.5x3.2mm_P2.1mm

Connections:
+3V3: C42.2, C43.2, C50.2, C51.2, C53.2, U10.11 (VLOGIC), U12.20 (DVDD), Y2.4 (VDD); also elsewhere on the board
+5VA: C44.1, C54.1, C55.1, C56.1, FB2.1, U11.1 (IN), U11.3 (EN), U13.4 (V+), U14.3 (EN), U14.4 (IN); also elsewhere on the board
-5VA: C57.1, U13.11 (V-); also elsewhere on the board
/ADC & DAC/CLAMP+: R71.1, U13.8; also elsewhere on the board
/ADC & DAC/CLAMP-: R72.1, U13.14; also elsewhere on the board
/ADC & DAC/CS_ADC: U12.12 (~CS); also elsewhere on the board
/ADC & DAC/CS_DAC: U10.13 (~SYNC); also elsewhere on the board
/ADC & DAC/FI: R70.1, U13.7; also elsewhere on the board
/ADC & DAC/FV: R69.1, U13.1; also elsewhere on the board
/ADC & DAC/IMEAS: R61.2; also elsewhere on the board
/ADC & DAC/MISO_ADC: U12.15 (DOUT); also elsewhere on the board
/ADC & DAC/MISO_DAC: U10.8 (SDO); also elsewhere on the board
/ADC & DAC/MOSI_ADC: U12.16 (DIN); also elsewhere on the board
/ADC & DAC/MOSI_DAC: U10.14 (SDIN); also elsewhere on the board
/ADC & DAC/PAOUT: R57.2; also elsewhere on the board
/ADC & DAC/SCK_ADC: U12.14 (SCLK); also elsewhere on the board
/ADC & DAC/SCK_DAC: U10.12 (SCLK); also elsewhere on the board
/ADC & DAC/VMEAS: R58.2; also elsewhere on the board
/ADC & DAC/VREF: R65.2, R66.2, R67.2, R68.2, TP5.1 (1_1), U10.1 (VREF), U14.5 (Vref)
/ADC & DAC/~DRDY_ADC: U12.13 (~DRDY); also elsewhere on the board
/ADC & DAC/~RESET_ADC: U12.11 (~SYNC/~RESET); also elsewhere on the board
/ADC & DAC/~RESET_DAC: U10.15 (~RESET); also elsewhere on the board
GND: C40.2, C41.2, C42.1, C43.1, C44.2, C45.2, C46.2, C47.2, C48.1, C49.1, C50.1, C51.1, C52.2, C53.1, C54.2, C55.2, C56.2, C57.2, R60.1, U10.4 (GND), U10.9 (~LDAC), U10.10 (GAIN), U10.16 (RSTSEL), U11.2 (GND), U12.2 (AGND), U12.4 (AIN0N), U12.5 (AIN1N), U12.8 (AIN2N), U12.19 (DGND), U14.2 (GND), Y2.2 (GND); also elsewhere on the board
unnamed: R57.1, R59.2
unnamed: R58.1, R62.2
unnamed: R63.2, R64.2, U2.1
unnamed: R59.1, R60.2, U2.3 (+)
unnamed: R63.1, U2.2 (-)
unnamed: C45.1, C46.1, FB2.2, U10.5 (VDD)
unnamed: U10.3 (VOUTA), U13.5 (+)
unnamed: U10.2 (VOUTB), U13.10 (+)
unnamed: U10.6 (VOUTC), U13.3 (+)
unnamed: U10.7 (VOUTD), U13.12 (+)
unnamed: C48.2, C49.2, U11.5 (OUT), U12.1 (AVDD)
unnamed: C40.1, R61.1, U12.3 (AIN0P)
unnamed: C41.1, R62.1, U12.6 (AIN1P)
unnamed: C47.1, R64.1, U12.7 (AIN2P)
unnamed: C52.1, U12.18 (CAP)
unnamed: U12.17 (CLKIN), Y2.3 (OUT)
unnamed: R65.1, R69.2, U13.2 (-)
unnamed: R66.1, R70.2, U13.6 (-)
unnamed: R67.1, R71.2, U13.9 (-)
unnamed: R68.1, R72.2, U13.13 (-)
unnamed: TP4.1 (1_1), U14.1 (Vbias)

Notes on the sheet:
ADC, measurement signal conditioning
DAC, force and complience signals conditioning
Voltage Reference
