bodri/smuk/hardware/sense/sense.kicad_pcb

## KiCad design hardware/sense/sense.kicad_pcb (continued)

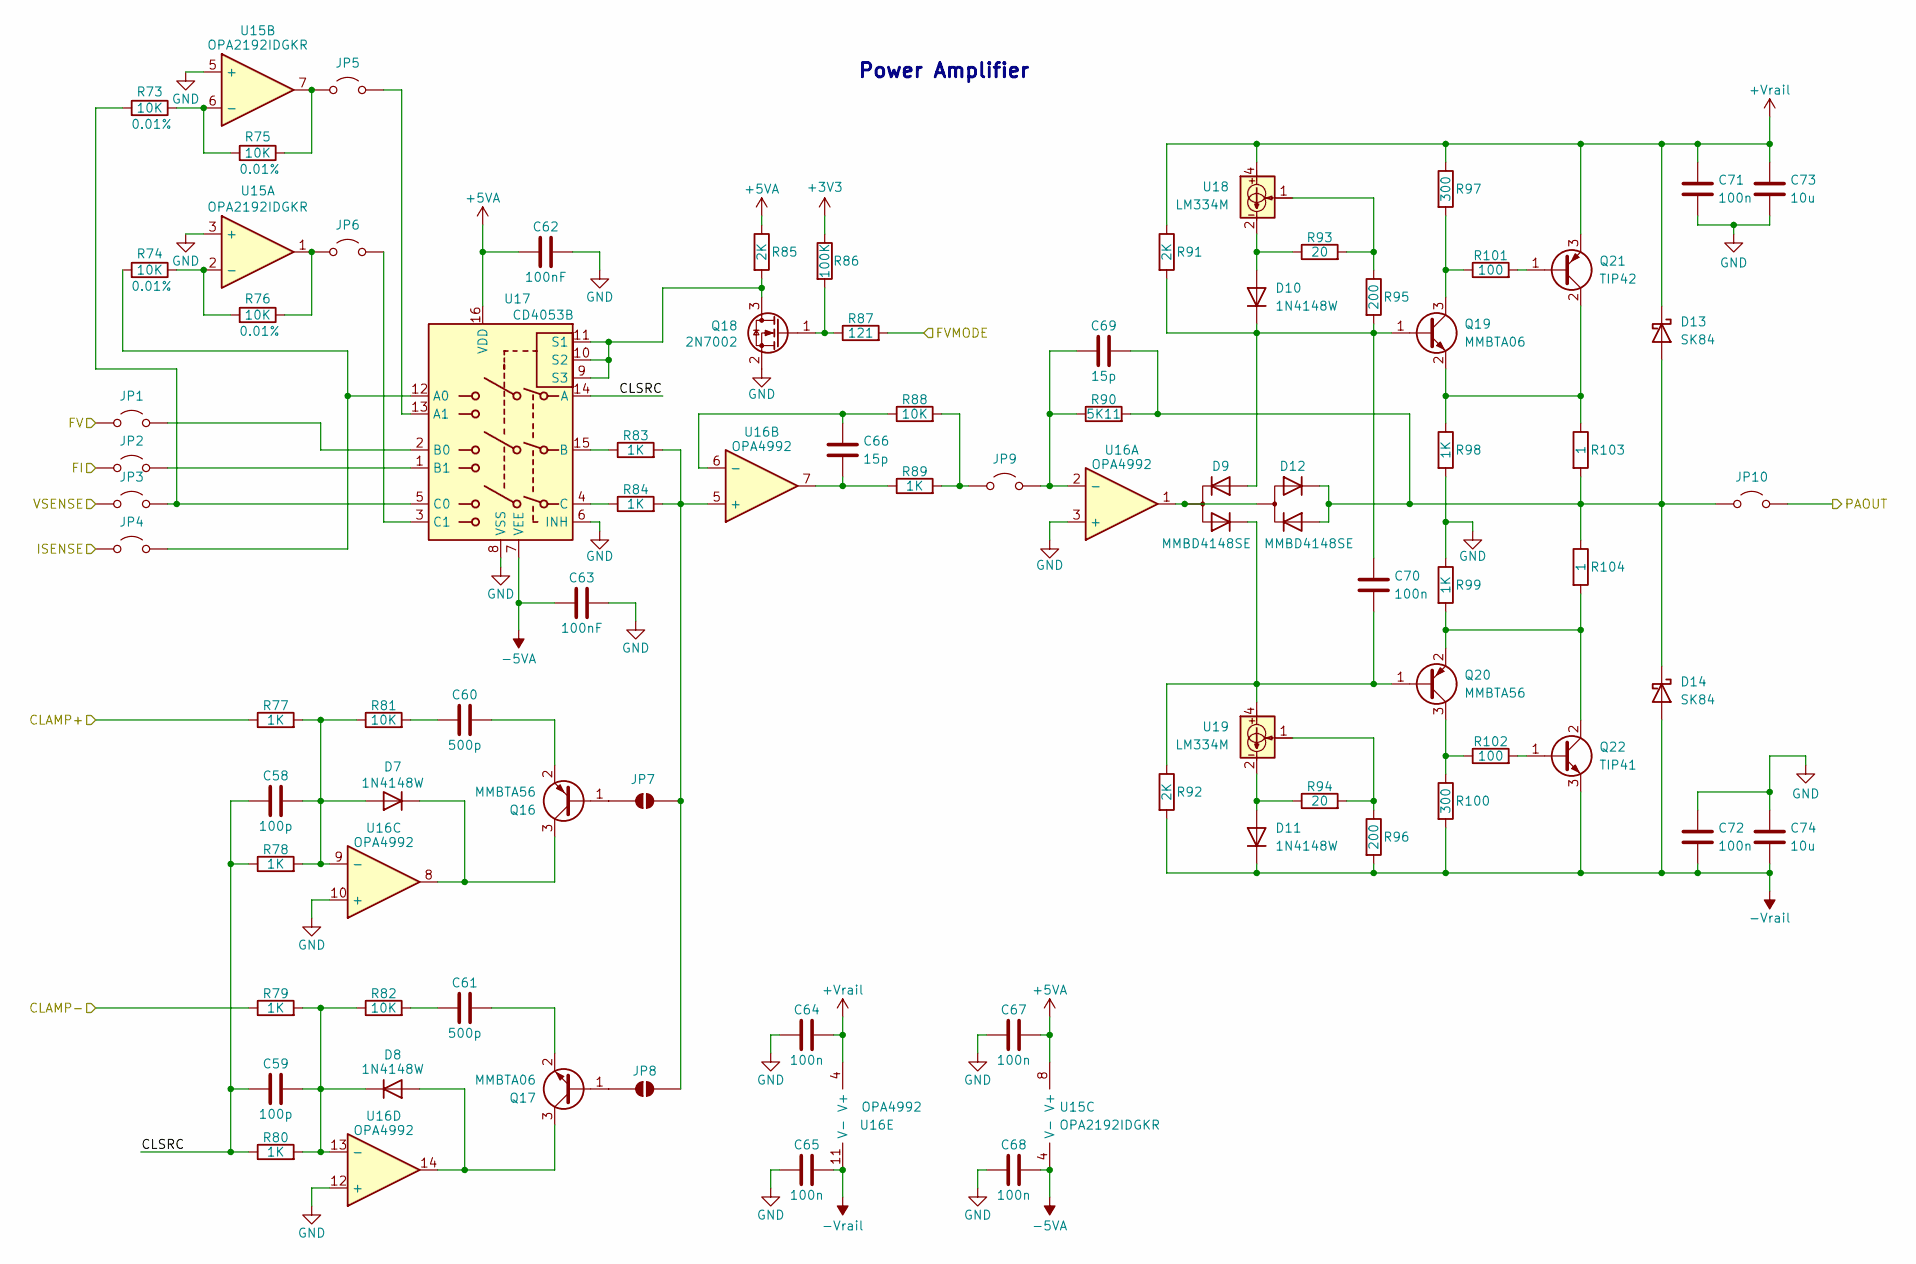
[picture p13: schematic pa.kicad_sch, SMUK (SMU by Kapuki)]

Parts:
C58, C59: 100p; C_0603_1608Metric
C60, C61: 500p; C_0603_1608Metric
C62, C63: 100nF; C_0603_1608Metric
C64, C65, C67, C68: 100n; C_0603_1608Metric
C66: 15p; C_0603_1608Metric
C69: 15p; C_1206_3216Metric
C70, C71, C72: 100n; C_1206_3216Metric
C73, C74: 10u; C_1210_3225Metric
D7, D8, D10, D11: 1N4148W; D_SOD-123
D9, D12: MMBD4148SE; SOT-23
D13, D14: SK84; D_SMC
JP1, JP2, JP3, JP4, JP5, JP6, JP9, JP10: Jumper_2_Open; TestPoint_2Pads_Pitch2.54mm_Drill0.8mm
JP7, JP8: SolderJumper_2_Open; SolderJumper-2_P1.3mm_Open_RoundedPad1.0x1.5mm
Q16, Q20: MMBTA56; SOT-23
Q17, Q19: MMBTA06; SOT-23
Q18: 2N7002; SOT-23
Q21: TIP42; TO-220-3_Vertical
Q22: TIP41; TO-220-3_Vertical
R73, R74, R75, R76, R81, R82, R88: 10K; R_0603_1608Metric
R77, R78, R79, R80, R89: 1K; R_0603_1608Metric
R83, R84: 1K; R_1206_3216Metric
R85: 2K; R_0603_1608Metric
R86: 100K; R_0603_1608Metric
R87: 121; R_0603_1608Metric
R90: 5K11; R_1206_3216Metric
R91, R92: 2K; R_1206_3216Metric
R93, R94: 20; R_0805_2012Metric
R95, R96: 200; R_0805_2012Metric
R97, R100: 300; R_0805_2012Metric
R98, R99: 1K; R_2512_6332Metric
R101, R102: 100; R_0805_2012Metric
R103, R104: 1; R_2512_6332Metric
U15: OPA2192IDGKR; VSSOP-8_3x3mm_P0.65mm
U16: OPA4992; TSSOP-14_4.4x5mm_P0.65mm
U17: CD4053B; TSSOP-16_4.4x5mm_P0.65mm
U18, U19: LM334M; SOIC-8_3.9x4.9mm_P1.27mm

Connections:
+3V3: R86.1; also elsewhere on the board
+5VA: C62.1, C67.1, R85.1, U15.8 (V+), U17.16 (VDD); also elsewhere on the board
+Vrail: C64.1, C71.1, C73.1, D13.1 (K), Q21.3 (E), R91.1, R97.1, U16.4 (V+), U18.4; also elsewhere on the board
-5VA: C63.1, C68.1, U15.4 (V-), U17.7 (VEE); also elsewhere on the board
-Vrail: C65.1, C72.2, C74.2, D11.1 (K), D14.2 (A), Q22.3 (E), R92.2, R96.2, R100.2, U16.11 (V-); also elsewhere on the board
/ADC & DAC/CLAMP+: R77.1; also elsewhere on the board
/ADC & DAC/CLAMP-: R79.1; also elsewhere on the board
/ADC & DAC/FI: JP2.1 (A); also elsewhere on the board
/ADC & DAC/FV: JP1.1 (A); also elsewhere on the board
/ADC & DAC/PAOUT: JP10.2 (B); also elsewhere on the board
/Current Sense/ISENSE: JP4.1 (A); also elsewhere on the board
/Floating MCU/FVMODE: R87.2; also elsewhere on the board
/Power Amplifier/CLSRC: C58.1, C59.1, R78.1, R80.1, U17.14 (A)
/Power Amplifier/VSENSE: JP3.1 (A); also elsewhere on the board
GND: C62.2, C63.2, C64.2, C65.2, C67.2, C68.2, C71.2, C72.1, C73.2, C74.1, Q18.2 (S), R98.2, R99.1, U15.3 (+), U15.5 (+), U16.3 (+), U16.10 (+), U16.12 (+), U17.6 (INH), U17.8 (VSS); also elsewhere on the board
unnamed: C60.1, R81.2
unnamed: C61.1, R82.2
unnamed: C66.2, R89.1, U16.7
unnamed: C58.2, D7.2 (A), R77.2, R78.2, R81.1, U16.9 (-)
unnamed: D7.1 (K), Q16.3 (C), U16.8
unnamed: D8.2 (A), Q17.3 (C), U16.14
unnamed: C59.2, D8.1 (K), R79.2, R80.2, R82.1, U16.13 (-)
unnamed: D10.2 (A), R93.1, U18.2, U18.3, U18.6, U18.7
unnamed: C70.1, D9.1, D10.1 (K), Q19.1 (B), R91.2, R95.2
unnamed: D11.2 (A), R94.1, U19.2, U19.3, U19.6, U19.7
unnamed: D9.3, D12.3, U16.1
unnamed: C69.2, D12.1, D12.2, D13.2 (A), D14.1 (K), JP10.1 (A), R90.2, R103.2, R104.1
unnamed: JP1.2 (B), U17.2 (B0)
unnamed: JP2.2 (B), U17.1 (B1)
unnamed: JP3.2 (B), R73.2, U17.5 (C0)
unnamed: JP4.2 (B), R74.2, U17.12 (A0)
unnamed: JP5.1 (A), R75.1, U15.7
unnamed: JP5.2 (B), U17.13 (A1)
unnamed: JP6.1 (A), R76.1, U15.1
unnamed: JP6.2 (B), U17.3 (C1)
unnamed: JP7.1 (A), Q16.1 (B)
unnamed: JP7.2 (B), JP8.2 (B), R83.2, R84.2, U16.5 (+)
unnamed: JP8.1 (A), Q17.1 (B)
unnamed: JP9.1 (A), R88.2, R89.2
unnamed: C69.1, JP9.2 (B), R90.1, U16.2 (-)
unnamed: C60.2, Q16.2 (E)
unnamed: C61.2, Q17.2 (E)
unnamed: Q18.3 (D), R85.2, U17.9 (S3), U17.10 (S2), U17.11 (S1)
unnamed: Q18.1 (G), R86.2, R87.1
unnamed: Q19.3 (C), R97.2, R101.1
unnamed: Q19.2 (E), Q21.2 (C), R98.1, R103.1
unnamed: C70.2, D9.2, Q20.1 (B), R92.1, U19.4
unnamed: Q20.3 (C), R100.1, R102.1
unnamed: Q20.2 (E), Q22.2 (C), R99.2, R104.2
unnamed: Q21.1 (B), R101.2
unnamed: Q22.1 (B), R102.2
unnamed: R93.2, R95.1, U18.1
unnamed: R94.2, R96.1, U19.1
unnamed: R74.1, R76.2, U15.2 (-)
unnamed: R73.1, R75.2, U15.6 (-)
unnamed: C66.1, R88.1, U16.6 (-)
unnamed: R83.1, U17.15 (B)
unnamed: R84.1, U17.4 (C)

Notes on the sheet:
Power Amplifier

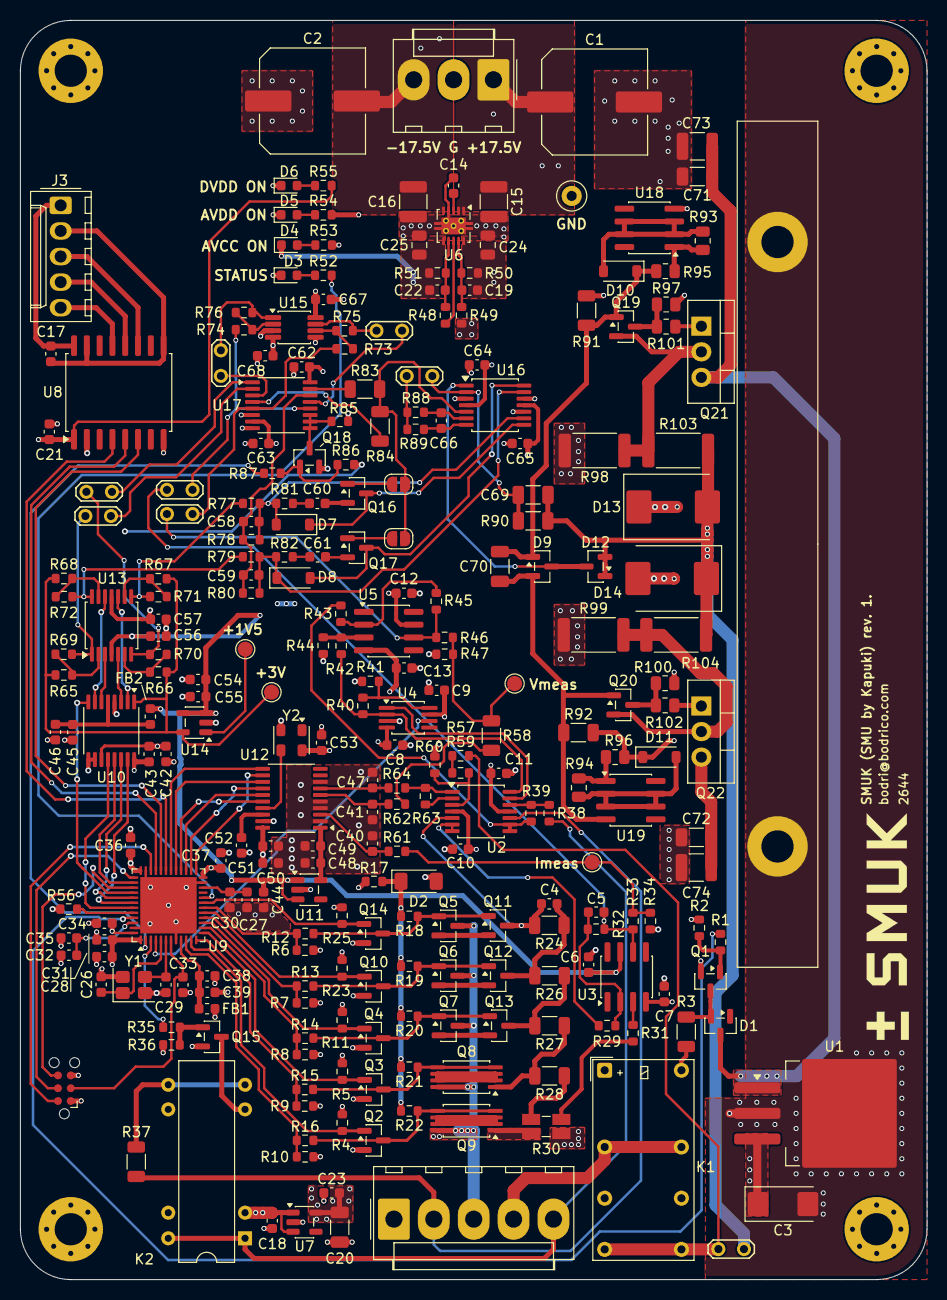
[picture p14: board sense.kicad_pcb from above]

Board: 4 copper layers, 90.0 x 125.0 mm, 263 parts (0 on the bottom side), 172 nets.
