bodri/smuk/hardware/pcb/smuk.kicad_pcb

## KiCad design hardware/pcb/smuk.kicad_pcb (2026-11-12)

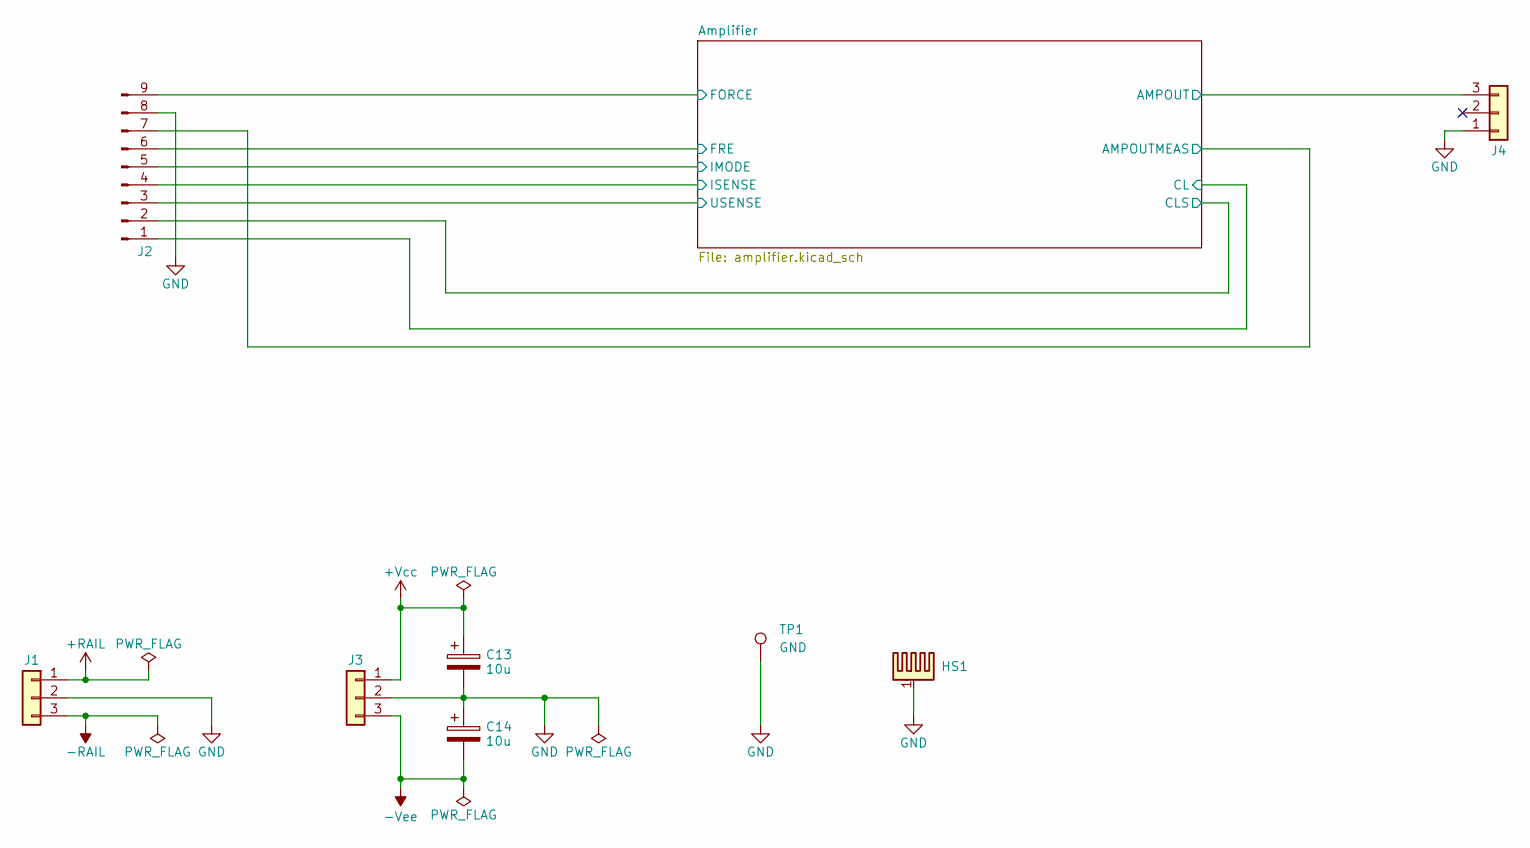
[picture p15: schematic smuk.kicad_sch]

Parts:
C13, C14: 10u; CP_EIA-6032-28_Kemet-C
HS1: Heatsink_Pad; Heatsink_Fischer_SK96-84SA_2Fixations
J1, J3, J4: Conn_01x03; Molex_KK-396_A-41791-0003_1x03_P3.96mm_Vertical
J2: Conn_01x09_Pin; PinHeader_1x09_P2.54mm_Horizontal
TP1: GND; TestPoint_Loop_D1.80mm_Drill1.0mm_Beaded

Connections:
+RAIL: J1.1; also elsewhere on the board
+Vcc: C13.1, J3.1; also elsewhere on the board
-RAIL: J1.3; also elsewhere on the board
-Vee: C14.2, J3.3; also elsewhere on the board
/Amplifier/AMPOUT: J4.3; also elsewhere on the board
/Amplifier/AMPOUTMEAS: J2.7; also elsewhere on the board
/Amplifier/CL: J2.1; also elsewhere on the board
/Amplifier/CLS: J2.2; also elsewhere on the board
/Amplifier/FORCE: J2.9; also elsewhere on the board
/Amplifier/FRE: J2.6; also elsewhere on the board
/Amplifier/IMODE: J2.5; also elsewhere on the board
/Amplifier/ISENSE: J2.4; also elsewhere on the board
/Amplifier/USENSE: J2.3; also elsewhere on the board
GND: C13.2, C14.1, HS1.1, J1.2, J2.8, J3.2, J4.1, TP1.1 (1_1); also elsewhere on the board

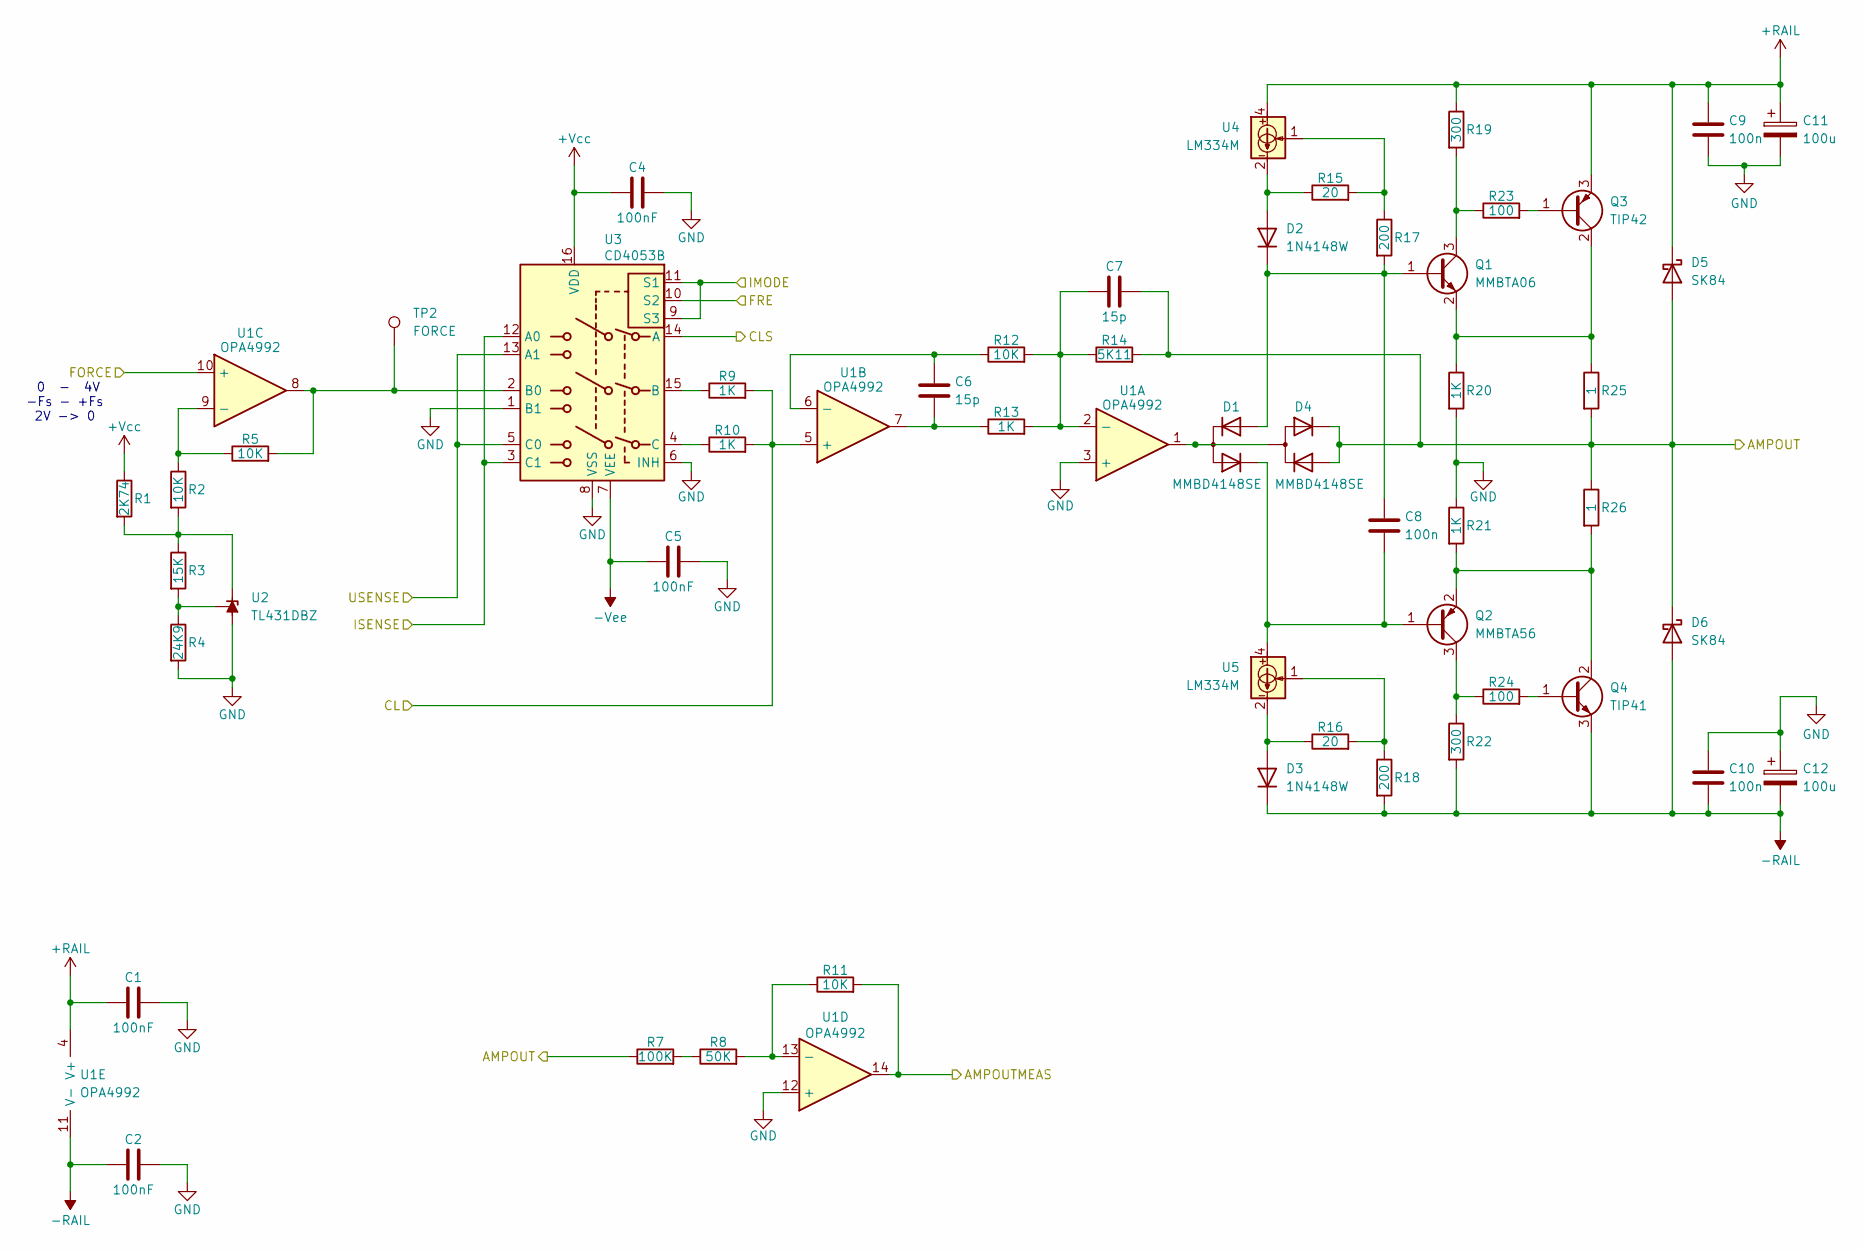
[picture p16: schematic amplifier.kicad_sch]

Parts:
C1, C2, C4, C5: 100nF; C_0805_2012Metric
C6: 15p; C_1206_3216Metric
C7: 15p; C_0805_2012Metric
C8: 100n; C_1206_3216Metric
C9, C10: 100n; C_0805_2012Metric
C11, C12: 100u; C_Elec_10x10.2
D1, D4: MMBD4148SE; SOT-23
D2, D3: 1N4148W; D_SOD-123
D5, D6: SK84; D_SMC
Q1: MMBTA06; SOT-23
Q2: MMBTA56; SOT-23
Q3: TIP42; TO-220-3_Vertical
Q4: TIP41; TO-220-3_Vertical
R1: 2K74; R_0805_2012Metric
R2, R5, R11, R12: 10K; R_0805_2012Metric
R3: 15K; R_0805_2012Metric
R4: 24K9; R_0805_2012Metric
R7: 100K; R_0805_2012Metric
R8: 50K; R_0805_2012Metric
R9, R10: 1K; R_1206_3216Metric
R13: 1K; R_0805_2012Metric
R14: 5K11; R_0805_2012Metric
R15, R16: 20; R_0805_2012Metric
R17, R18: 200; R_0805_2012Metric
R19, R22: 300; R_0805_2012Metric
R20, R21: 1K; R_2512_6332Metric
R23, R24: 100; R_0805_2012Metric
R25, R26: 1; R_2512_6332Metric
TP2: FORCE; TestPoint_Loop_D1.80mm_Drill1.0mm_Beaded
U1: OPA4992; TSSOP-14_4.4x5mm_P0.65mm
U2: TL431DBZ; SOT-23
U3: CD4053B; TSSOP-16_4.4x5mm_P0.65mm
U4, U5: LM334M; SOIC-8_3.9x4.9mm_P1.27mm

Connections:
+RAIL: C1.1, C9.1, C11.1, D5.1 (K), Q3.3 (E), R19.1, U1.4 (V+), U4.4; also elsewhere on the board
+Vcc: C4.1, R1.1, U3.16 (VDD); also elsewhere on the board
-RAIL: C2.1, C10.2, C12.2, D3.1 (K), D6.2 (A), Q4.3 (E), R18.2, R22.2, U1.11 (V-); also elsewhere on the board
-Vee: C5.1, U3.7 (VEE); also elsewhere on the board
/Amplifier/AMPOUT: C7.2, D4.1, D4.2, D5.2 (A), D6.1 (K), R7.1, R14.2, R25.2, R26.1; also elsewhere on the board
/Amplifier/AMPOUTMEAS: R11.2, U1.14; also elsewhere on the board
/Amplifier/CL: R9.2, R10.2, U1.5 (+); also elsewhere on the board
/Amplifier/CLS: U3.14 (A); also elsewhere on the board
/Amplifier/FORCE: U1.10 (+); also elsewhere on the board
/Amplifier/FRE: U3.10 (S2); also elsewhere on the board
/Amplifier/IMODE: U3.9 (S3), U3.11 (S1); also elsewhere on the board
/Amplifier/ISENSE: U3.3 (C1), U3.12 (A0); also elsewhere on the board
/Amplifier/USENSE: U3.5 (C0), U3.13 (A1); also elsewhere on the board
GND: C1.2, C2.2, C4.2, C5.2, C9.2, C10.1, C11.2, C12.1, R4.2, R20.2, R21.1, U1.3 (+), U1.12 (+), U2.3 (A), U3.1 (B1), U3.6 (INH), U3.8 (VSS); also elsewhere on the board
unnamed: C6.2, R13.1, U1.7
unnamed: D1.3, D4.3, U1.1
unnamed: D2.2 (A), R15.1, U4.2, U4.3, U4.6, U4.7
unnamed: C8.1, D1.1, D2.1 (K), Q1.1 (B), R17.2
unnamed: D3.2 (A), R16.1, U5.2, U5.3, U5.6, U5.7
unnamed: Q1.3 (C), R19.2, R23.1
unnamed: Q1.2 (E), Q3.2 (C), R20.1, R25.1
unnamed: C8.2, D1.2, Q2.1 (B), U5.4
unnamed: Q2.3 (C), R22.1, R24.1
unnamed: Q2.2 (E), Q4.2 (C), R21.2, R26.2
unnamed: Q3.1 (B), R23.2
unnamed: Q4.1 (B), R24.2
unnamed: R7.2, R8.1
unnamed: R15.2, R17.1, U4.1
unnamed: R16.2, R18.1, U5.1
unnamed: C7.1, R12.2, R13.2, R14.1, U1.2 (-)
unnamed: C6.1, R12.1, U1.6 (-)
unnamed: R2.1, R5.1, U1.9 (-)
unnamed: R8.2, R11.1, U1.13 (-)
unnamed: R1.2, R2.2, R3.1, U2.1 (K)
unnamed: R3.2, R4.1, U2.2 (REF)
unnamed: R5.2, TP2.1 (1_1), U1.8, U3.2 (B0)
unnamed: R9.1, U3.15 (B)
unnamed: R10.1, U3.4 (C)

Notes on the sheet:
0 - 4V -Fs - +Fs 2V -> 0

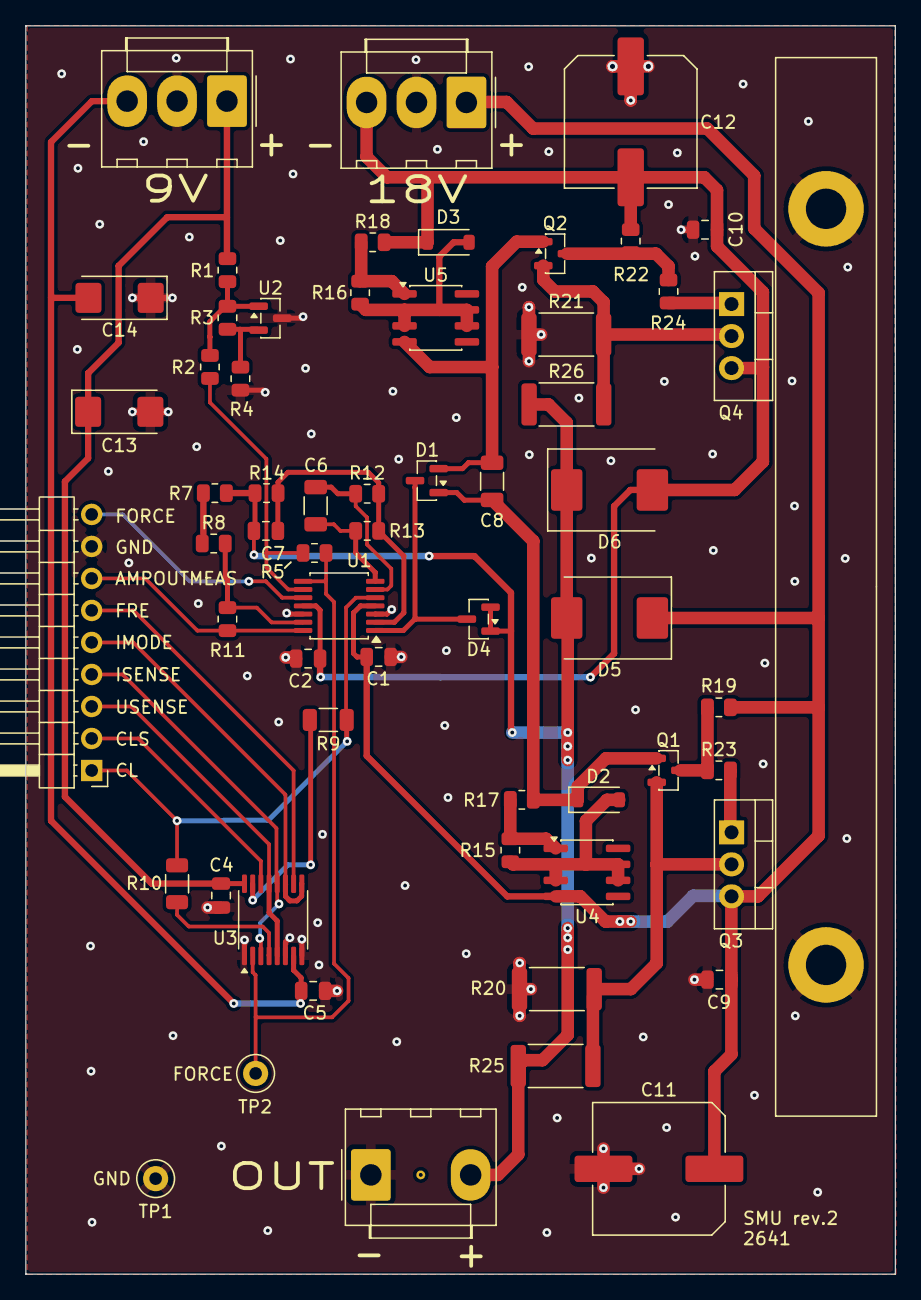
[picture p17: board hardware/pcb/smuk.kicad_pcb from above]

Board: 2 copper layers, 69.0 x 99.1 mm, 60 parts (0 on the bottom side), 38 nets.
