bodri/smuk/hardware/lt1970a/smuk.kicad_pcb

## KiCad design hardware/lt1970a/smuk.kicad_pcb (2026-10-13)

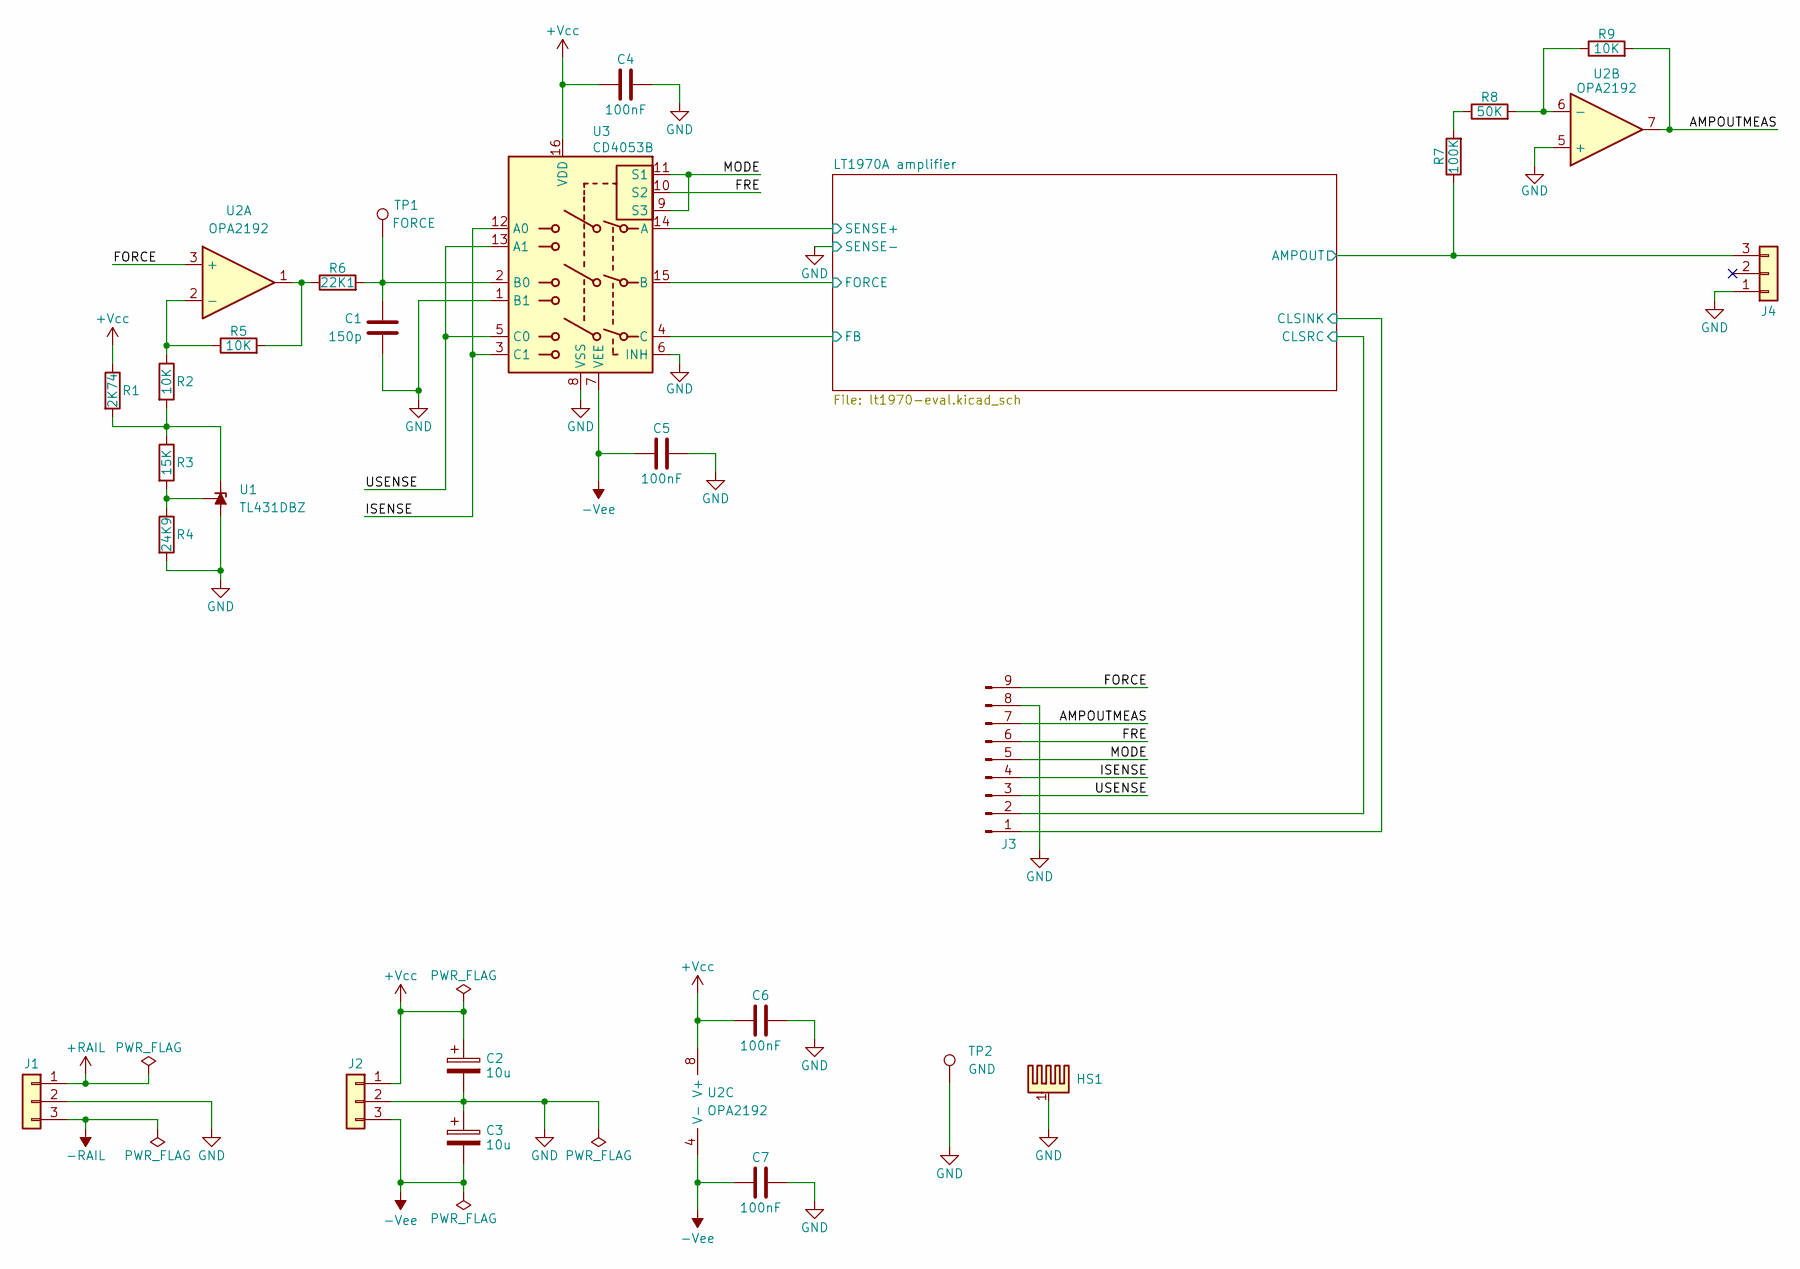
[picture p18: schematic smuk.kicad_sch]

Parts:
C1: 150p; C_0603_1608Metric
C2, C3: 10u; CP_EIA-6032-28_Kemet-C
C4, C5, C6, C7: 100nF; C_0603_1608Metric
HS1: Heatsink_Pad; Heatsink_Fischer_SK96-84SA_2Fixations
J1, J2, J4: Conn_01x03; Molex_KK-396_A-41791-0003_1x03_P3.96mm_Vertical
J3: Conn_01x09_Pin; PinHeader_1x09_P2.54mm_Horizontal
R1: 2K74; R_0603_1608Metric
R2, R5, R9: 10K; R_0603_1608Metric
R3: 15K; R_0603_1608Metric
R4: 24K9; R_0603_1608Metric
R6: 22K1; R_0603_1608Metric
R7: 100K; R_0603_1608Metric
R8: 50K; R_0603_1608Metric
TP1: FORCE; TestPoint_Loop_D1.80mm_Drill1.0mm_Beaded
TP2: GND; TestPoint_Loop_D1.80mm_Drill1.0mm_Beaded
U1: TL431DBZ; SOT-23
U2: OPA2192; VSSOP-8_3x3mm_P0.65mm
U3: CD4053B; TSSOP-16_4.4x5mm_P0.65mm

Connections:
/AMPOUTMEAS: J3.7, R9.2, U2.7
/FORCE: J3.9, U2.3 (+)
/FRE: J3.6, U3.10 (S2)
/ISENSE: J3.4, U3.3 (C1), U3.12 (A0)
/LT1970A amplifier/AMPOUT: J4.3, R7.1; also elsewhere on the board
/LT1970A amplifier/CLSINK: J3.1; also elsewhere on the board
/LT1970A amplifier/CLSRC: J3.2; also elsewhere on the board
/LT1970A amplifier/FB: U3.4 (C); also elsewhere on the board
/LT1970A amplifier/FORCE: U3.15 (B); also elsewhere on the board
/LT1970A amplifier/SENSE+: U3.14 (A); also elsewhere on the board
/MODE: J3.5, U3.9 (S3), U3.11 (S1)
/USENSE: J3.3, U3.5 (C0), U3.13 (A1)
GND: C1.2, C2.2, C3.1, C4.2, C5.2, C6.2, C7.2, HS1.1, J1.2, J2.2, J3.8, J4.1, R4.2, TP2.1 (1_1), U1.3 (A), U2.5 (+), U3.1 (B1), U3.6 (INH), U3.8 (VSS); also elsewhere on the board
unnamed: R5.2, R6.1, U2.1
unnamed: R7.2, R8.1
unnamed: R1.2, R2.2, R3.1, U1.1 (K)
unnamed: R3.2, R4.1, U1.2 (REF)
unnamed: R2.1, R5.1, U2.2 (-)
unnamed: R8.2, R9.1, U2.6 (-)
unnamed: C1.1, R6.2, TP1.1 (1_1), U3.2 (B0)

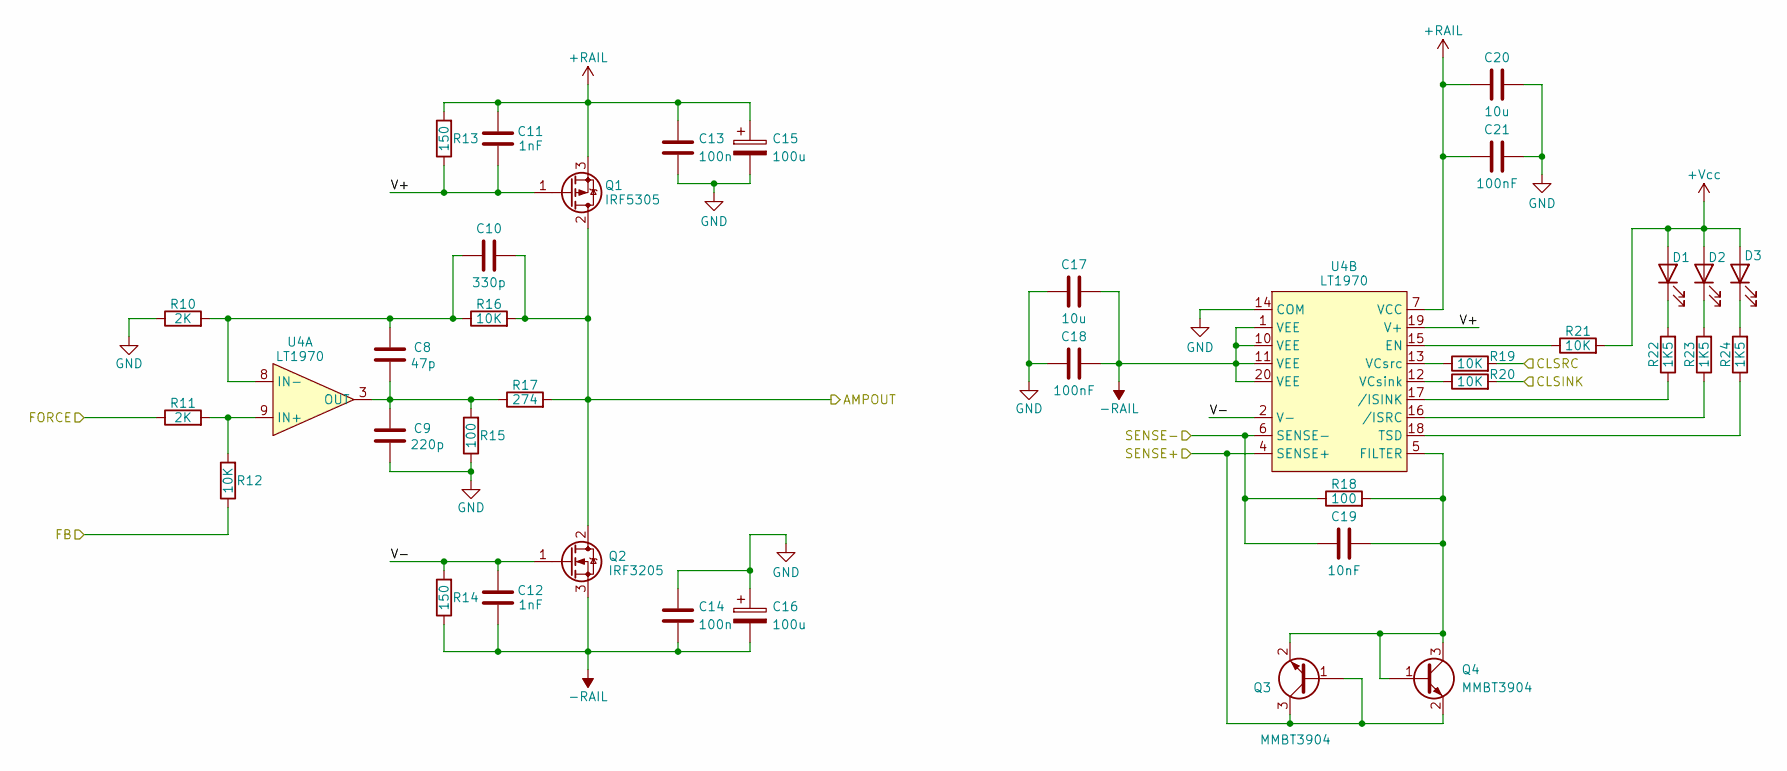
[picture p19: schematic lt1970-eval.kicad_sch]

Parts:
C8: 47p; C_0603_1608Metric
C9: 220p; C_0603_1608Metric
C10: 330p; C_0603_1608Metric
C11, C12: 1nF; C_0603_1608Metric
C13, C14: 100n; C_0603_1608Metric
C15, C16: 100u; C_Elec_10x10.2
C17, C20: 10u; C_0603_1608Metric
C18, C21: 100nF; C_0603_1608Metric
C19: 10nF; C_0603_1608Metric
D1, D2, D3: LED; LED_0603_1608Metric
Q1: IRF5305; TO-220-3_Vertical
Q2: IRF3205; TO-220-3_Vertical
Q3, Q4: MMBT3904; SOT-323_SC-70
R10, R11: 2K; R_0603_1608Metric
R12, R16, R19, R20, R21: 10K; R_0603_1608Metric
R13, R14: 150; R_0603_1608Metric
R15, R18: 100; R_0603_1608Metric
R17: 274; R_0603_1608Metric
R22, R23, R24: 1K5; R_0603_1608Metric
U4: LT1970

Connections:
/LT1970A amplifier/AMPOUT: C10.1, Q1.2 (D), Q2.2 (D), R16.2, R17.2; also elsewhere on the board
/LT1970A amplifier/CLSINK: R20.2; also elsewhere on the board
/LT1970A amplifier/CLSRC: R19.2; also elsewhere on the board
/LT1970A amplifier/FB: R12.1; also elsewhere on the board
/LT1970A amplifier/FORCE: R11.1; also elsewhere on the board
/LT1970A amplifier/SENSE+: Q3.1 (B), Q3.3 (C), Q4.2 (E), U4.4 (SENSE+); also elsewhere on the board
/LT1970A amplifier/V+: C11.2, Q1.1 (G), R13.1, U4.19 (V+)
/LT1970A amplifier/V-: C12.1, Q2.1 (G), R14.2, U4.2 (V-)
GND: C9.2, C13.2, C14.1, C15.2, C16.1, C17.2, C18.2, C19.1, C20.2, C21.2, R10.1, R15.1, R18.1, U4.6 (SENSE-), U4.14 (COM); also elsewhere on the board
unnamed: D1.1 (K), R22.2
unnamed: D2.1 (K), R23.2
unnamed: D3.1 (K), R24.2
unnamed: C19.2, Q3.2 (E), Q4.1 (B), Q4.3 (C), R18.2, U4.5 (FILTER)
unnamed: R11.2, R12.2, U4.9 (IN+)
unnamed: C8.1, C10.2, R10.2, R16.1, U4.8 (IN-)
unnamed: C8.2, C9.1, R15.2, R17.1, U4.3 (OUT)
unnamed: R21.1, U4.15 (EN)
unnamed: R24.1, U4.18 (TSD)
unnamed: R20.1, U4.12 (VCsink)
unnamed: R19.1, U4.13 (VCsrc)
unnamed: R22.1, U4.17 (/ISINK)
unnamed: R23.1, U4.16 (/ISRC)
VCC: D1.2 (A), D2.2 (A), D3.2 (A), R21.2

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
Board: 2 copper layers, 63 parts (0 on the bottom side), 40 nets, no tracks yet.
