bodri/smuk/firmware/Core/Src/main.c

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
/* Includes ------------------------------------------------------------------*/
#include "main.h"
#include "dac.h"
#include "gpdma.h"
#include "gpio.h"
#include "icache.h"
#include "spi.h"

/* USER CODE BEGIN Includes */

#include "safety_hw.h"
#include "smu.h"
#include "smu_console.h"
#include "smu_watchdog.h"

/* USER CODE END Includes */


COM_InitTypeDef BspCOMInit;

/* USER CODE BEGIN PV */

const smu_context_t* smu_ctx;
smu_measurement_outputs_t out;

/* USER CODE END PV */

void SystemClock_Config(void);
/**
 * @brief  The application entry point.
 * @retval int
 */
int main(void) {
    /* MCU Configuration--------------------------------------------------------*/

    /* Reset of all peripherals, Initializes the Flash interface and the Systick. */
    HAL_Init();

    /* Configure the system clock */
    SystemClock_Config();

    /* Initialize all configured peripherals */
    MX_GPIO_Init();
    MX_GPDMA1_Init();
    MX_SPI1_Init();
    MX_ICACHE_Init();
    MX_DAC1_Init();
    /* Initialize USER push-button, will be used to trigger an interrupt each time it's pressed.*/
    BSP_PB_Init(BUTTON_USER, BUTTON_MODE_EXTI);

    /* Initialize COM1 port (115200, 8 bits (7-bit data + 1 stop bit), no parity */
    BspCOMInit.BaudRate = 115200;
    BspCOMInit.WordLength = COM_WORDLENGTH_8B;
    BspCOMInit.StopBits = COM_STOPBITS_1;
    BspCOMInit.Parity = COM_PARITY_NONE;
    BspCOMInit.HwFlowCtl = COM_HWCONTROL_NONE;
    if (BSP_COM_Init(COM1, &BspCOMInit) != BSP_ERROR_NONE) {
        Error_Handler();
    }

    /* Infinite loop */
    /* USER CODE BEGIN WHILE */

    /* UART is initialized above; expose logs before instrument bring-up. */
    if (!smu_console_transport_init()) {
        Error_Handler();
    }

    if (!smu_watchdog_start()) {
        Error_Handler();
    }

    /* Calibration load, ADS131M03 bring-up, boot ranges and acquisition. */
    if (!smu_init()) {
        Error_Handler();
    }

    smu_ctx = smu_get_context();

    if (!smu_console_init()) {
        Error_Handler();
    }

    while (1) {
        smu_process();
        smu_console_process();
        smu_get_measurement(&out);
        if (!smu_watchdog_service(smu_ctx->state, safety_hw_pa_requested(), smu_ctx->input_10m_active)) {
            Error_Handler();
        }

        /* USER CODE END WHILE */

        /* USER CODE BEGIN 3 */
    }
    /* USER CODE END 3 */
}

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
