bodri/smuk/hardware/sense/smuk/smuk.ioc

Mcu.UserName=STM32H503CBUx
PA0.GPIO_Label=IR2A_M
PA0.Signal=ADCx_INP0
PA1.GPIO_Label=IR2A
PA1.Signal=GPIO_Output
PA11.Signal=USART1_RX
PA12.Signal=USART1_TX
PA13(JTMS/SWDIO).Signal=DEBUG_JTMS-SWDIO
PA14(JTCK/SWCLK).Signal=DEBUG_JTCK-SWCLK
PA15(JTDI).Signal=SPI3_NSS
PA2.GPIO_Label=IR100MA_M
PA2.Signal=ADCx_INP14
PA3.GPIO_Label=IR100MA
PA3.Signal=GPIO_Output
PA4.GPIO_Label=IR10MA_M
PA4.Signal=ADCx_INP18
PA5.GPIO_Label=IR10MA
PA5.Signal=GPIO_Output
PA6.GPIO_Label=IR1MA_M
PA6.Signal=ADCx_INP3
PA7.GPIO_Label=IR1MA
PA7.Signal=GPIO_Output
PA8.GPIO_Label=NDRDY_ADC
PA8.Signal=GPXTI8
PA9.GPIO_Label=NRESET_ADC
PA9.Signal=GPIO_Output
PB0.GPIO_Label=IR100UA_M
PB0.Signal=ADCx_INP9
PB1.GPIO_Label=IR100UA
PB1.Signal=GPIO_Output
PB12.GPIO_Label=CS_ADC
PB12.Signal=SPI2_NSS
PB13.GPIO_Label=SCK_ADC
PB13.Signal=SPI2_SCK
PB14.GPIO_Label=MISO_ADC
PB14.Signal=SPI2_MISO
PB15.GPIO_Label=MOSI_ADC
PB15.Signal=SPI2_MOSI
PB3(JTDO/TRACESWO).Signal=DEBUG_JTDO-SWO
PB4(NJTRST).GPIO_Label=MISO_DAC
PB4(NJTRST).Signal=SPI3_MISO
PB5.GPIO_Label=MOSI_DAC
PB5.Signal=SPI3_MOSI
PB6.GPIO_Label=NRESET_DAC
PB6.Signal=GPIO_Output
PB7.GPIO_Label=SCK_DAC
PB7.Signal=SPI3_SCK
PH0-OSC_IN(PH0).Signal=RCC_OSC_IN
PH1-OSC_OUT(PH1).Signal=RCC_OSC_OUT
