bodri/smuk/firmware/Core/Inc/main.h

#define MV_ON_Pin GPIO_PIN_2
#define MV_ON_GPIO_Port GPIOC
#define VRANGE_Pin GPIO_PIN_3
#define VRANGE_GPIO_Port GPIOC
#define IR1MA_Pin GPIO_PIN_0
#define IR1MA_GPIO_Port GPIOA
#define IR10MA_Pin GPIO_PIN_1
#define IR10MA_GPIO_Port GPIOA
#define ICAL_Pin GPIO_PIN_4
#define ICAL_GPIO_Port GPIOC
#define IR2A_Pin GPIO_PIN_0
#define IR2A_GPIO_Port GPIOB
#define IR100MA_Pin GPIO_PIN_1
#define IR100MA_GPIO_Port GPIOB
#define CALBUS_S0_Pin GPIO_PIN_12
#define CALBUS_S0_GPIO_Port GPIOB
#define CALBUS_S1_Pin GPIO_PIN_13
#define CALBUS_S1_GPIO_Port GPIOB
#define NDRDY_Pin GPIO_PIN_6
#define NDRDY_GPIO_Port GPIOC
#define NDRDY_EXTI_IRQn EXTI6_IRQn
#define VCAL_Pin GPIO_PIN_8
#define VCAL_GPIO_Port GPIOC
#define NRESET_Pin GPIO_PIN_9
#define NRESET_GPIO_Port GPIOC
#define IR100UA_Pin GPIO_PIN_12
#define IR100UA_GPIO_Port GPIOC
