bodri/smuk/firmware/App/smu_range.c

#include "smu_range.h"
#include "range_hw.h"
#include "safety_hw.h"
#include "smu_iforce.h"
#include "smu_measurement.h"
#include <math.h>

/* ~98% of the 24-bit positive full scale: treat as ADC clipping. */
#define ADC_CLIP_CODE 8220000

static bool range_is_valid(smu_current_range_t r) {
    return r >= SMU_RANGE_1P5A && r <= SMU_RANGE_100UA;
}

/* Enum order runs from the largest (1.5 A) to the smallest (100 uA) range. */
static bool is_smaller(smu_current_range_t a, smu_current_range_t b) {
    return (int)a > (int)b;
}

static bool fits(const smu_range_manager_t* rm, float abs_A, smu_current_range_t r) {
    return abs_A < rm->cfg.current_fit_fraction * smu_current_range_fs_A(r);
}

/* Smallest range that fits abs_A; 1.5 A if none does. */
static smu_current_range_t smallest_fit(const smu_range_manager_t* rm, float abs_A) {
    for (int r = SMU_RANGE_100UA; r > SMU_RANGE_1P5A; r--)
        if (fits(rm, abs_A, (smu_current_range_t)r))
            return (smu_current_range_t)r;
    return SMU_RANGE_1P5A;
}

static void reset_current_autorange(smu_range_manager_t* rm) {
    rm->current_up_count = 0;
    rm->current_down_ms = 0;
    rm->current_down_candidate = false;
}

static void reset_voltage_autorange(smu_range_manager_t* rm) {
    rm->voltage_up_count = 0;
    rm->voltage_down_ms = 0;
    rm->voltage_down_candidate = false;
    rm->voltage_frame_seen = false;
}

static void enter_fault(smu_range_manager_t* rm) {
    smu_range_disconnect_input(rm);
    range_hw_all_off();
    rm->error = SMU_RANGE_ERR_GATE_INVALID;
    rm->tx_state = SMU_RANGE_TX_FAULT;
    rm->measurement_valid = false;
    rm->servo_allowed = false;
    smu_measurement_set_range_transition(true);
}

static void apply_switch(smu_range_manager_t* rm) {
    uint16_t discard = 0;

    if (rm->tx_state == SMU_RANGE_TX_PENDING) {
        range_hw_select(rm->requested);
        if (!range_hw_is_selected(rm->requested)) {
            enter_fault(rm);
            return;
        }
        rm->active = rm->requested;
        smu_measurement_set_current_range(rm->active);
        discard = rm->cfg.current_discard_frames[rm->active];
        rm->switch_count++;
    }

    if (rm->vpending) {
        range_hw_select_voltage(rm->vrequested);
        if (range_hw_voltage_selected() != rm->vrequested) {
            enter_fault(rm);
            return;
        }
        rm->vactive = rm->vrequested;
        rm->vpending = false;
        smu_measurement_set_voltage_range(rm->vactive);
        if (rm->cfg.vrange_discard_frames > discard)
            discard = rm->cfg.vrange_discard_frames;
    }

    if (rm->impedance_pending) {
        const bool connect = rm->input_10m_requested && !rm->pa_inhibited && !rm->pa_off_wait_ms && !safety_hw_pa_requested();
        range_hw_input_10m(connect);
        rm->input_10m_active = range_hw_input_10m_is_on();
        if (rm->input_10m_active != connect) {
            enter_fault(rm);
            return;
        }
        rm->impedance_pending = false;
        if (rm->cfg.impedance_discard_frames > discard)
            discard = rm->cfg.impedance_discard_frames;
    }
    smu_measurement_set_range_transition(true);
    smu_measurement_reset_filters();
    rm->discard_left = discard;
    rm->tx_state = SMU_RANGE_TX_SETTLE;
    rm->measurement_valid = false;
    rm->servo_allowed = false;
    reset_current_autorange(rm);
    reset_voltage_autorange(rm);
}

void smu_range_init(smu_range_manager_t* rm) {
    *rm = (smu_range_manager_t){0};
    rm->active = SMU_RANGE_NONE;
    rm->requested = SMU_RANGE_NONE;
    rm->vactive = SMU_VRANGE_15V;
    rm->vrequested = SMU_VRANGE_15V;
    rm->tx_state = SMU_RANGE_TX_IDLE;

    rm->cfg.current_up_fraction = 0.90f;
    rm->cfg.current_overload_fraction = 1.05f;
    rm->cfg.current_fit_fraction = 0.70f;
    rm->cfg.current_up_confirm_frames = 2u * SMU_RATE_SCALE;
    rm->cfg.current_down_persist_ms = 50u;
    /* Preserve the original wall-clock settling at the configured rate:
     * The high-ohm shunts settle slowest. */
    rm->cfg.current_discard_frames[SMU_RANGE_1P5A] = 8u * SMU_RATE_SCALE;
    rm->cfg.current_discard_frames[SMU_RANGE_100MA] = 8u * SMU_RATE_SCALE;
    rm->cfg.current_discard_frames[SMU_RANGE_10MA] = 8u * SMU_RATE_SCALE;
    rm->cfg.current_discard_frames[SMU_RANGE_1MA] = 16u * SMU_RATE_SCALE;
    rm->cfg.current_discard_frames[SMU_RANGE_100UA] = 40u * SMU_RATE_SCALE;
    rm->cfg.vrange_discard_frames = 40u * SMU_RATE_SCALE;
    rm->cfg.resume_discard_frames = 40u * SMU_RATE_SCALE;
    rm->cfg.impedance_discard_frames = 40u * SMU_RATE_SCALE;
    rm->cfg.pa_off_settle_ms = 10u;
    rm->cfg.voltage_up_V = 6.2f;
    rm->cfg.voltage_down_V = 5.0f;
    rm->cfg.voltage_up_confirm_frames = 2u * SMU_RATE_SCALE;
    rm->cfg.voltage_down_persist_ms = 100u;
}

bool smu_range_request_input_10m(smu_range_manager_t* rm, bool enabled) {
    if (rm->tx_state == SMU_RANGE_TX_FAULT || (enabled && (rm->pa_inhibited || safety_hw_pa_requested())))
        return false;
    rm->input_10m_requested = enabled;
    rm->impedance_pending = enabled != rm->input_10m_active;
    if (rm->impedance_pending) {
        rm->measurement_valid = false;
        rm->servo_allowed = false;
        smu_measurement_set_range_transition(true);
    }
    return true;
}

void smu_range_inhibit_input_10m(smu_range_manager_t* rm, bool inhibited) {
    if (rm->pa_inhibited && !inhibited)
        rm->pa_off_wait_ms = rm->cfg.pa_off_settle_ms;
    rm->pa_inhibited = inhibited;
}

void smu_range_disconnect_input(smu_range_manager_t* rm) {
    range_hw_input_10m(false);
    rm->input_10m_active = false;
    rm->input_10m_requested = false;
    rm->impedance_pending = false;
}

bool smu_range_busy(const smu_range_manager_t* rm) {
    return rm->tx_state != SMU_RANGE_TX_IDLE || rm->vpending || rm->impedance_pending;
}

bool smu_range_request(smu_range_manager_t* rm, smu_current_range_t target, smu_range_reason_t reason) {
    if (!range_is_valid(target)) {
        rm->error = SMU_RANGE_ERR_BAD_REQUEST;
        return false;
    }
    if (rm->tx_state != SMU_RANGE_TX_IDLE) {
        rm->error = SMU_RANGE_ERR_BUSY;
        return false;
    }
    if (target == rm->active)
        return true;

    rm->requested = target;
    rm->reason = reason;
    rm->tx_state = SMU_RANGE_TX_PENDING;
    rm->measurement_valid = false;
    rm->servo_allowed = false;
    smu_measurement_set_range_transition(true);
    return true;
}

bool smu_range_request_voltage(smu_range_manager_t* rm, smu_voltage_range_t target) {
    if (target != SMU_VRANGE_15V && target != SMU_VRANGE_6V) {
        rm->error = SMU_RANGE_ERR_BAD_REQUEST;
        return false;
    }
    if (rm->tx_state == SMU_RANGE_TX_FAULT) {
        rm->error = SMU_RANGE_ERR_BUSY;
        return false;
    }
    rm->vrequested = target;
    rm->vpending = true;
    rm->measurement_valid = false;
    rm->servo_allowed = false;
    smu_measurement_set_range_transition(true);
    return true;
}

void smu_range_set_current_autorange(smu_range_manager_t* rm, bool enabled) {
    rm->current_autorange_enabled = enabled;
    reset_current_autorange(rm);
}

void smu_range_set_voltage_autorange(smu_range_manager_t* rm, bool enabled) {
    rm->voltage_autorange_enabled = enabled;
    reset_voltage_autorange(rm);
}

void smu_range_voltage_autorange_frame(smu_range_manager_t* rm, int32_t code, float voltage_V, float filtered_V) {
    /* A current switch can already be queued by this same frame. Combine the
     * voltage request with it, while the old range is still physically active. */
    if (!rm->voltage_autorange_enabled || rm->vpending || (rm->tx_state != SMU_RANGE_TX_IDLE && rm->tx_state != SMU_RANGE_TX_PENDING))
        return;
    rm->voltage_frame_seen = true;
    bool clipped = code >= ADC_CLIP_CODE || code <= -ADC_CLIP_CODE;
    if (rm->vactive == SMU_VRANGE_6V) {
        if (clipped || (isfinite(voltage_V) && fabsf(voltage_V) >= rm->cfg.voltage_up_V)) {
            if (rm->voltage_up_count < UINT16_MAX)
                ++rm->voltage_up_count;
            if (clipped || rm->voltage_up_count >= rm->cfg.voltage_up_confirm_frames)
                (void)smu_range_request_voltage(rm, SMU_VRANGE_15V);
        } else
            rm->voltage_up_count = 0;
        rm->voltage_down_candidate = false;
        rm->voltage_down_ms = 0;
    } else {
        rm->voltage_down_candidate = !clipped && isfinite(voltage_V) && isfinite(filtered_V) && fabsf(voltage_V) <= rm->cfg.voltage_down_V && fabsf(filtered_V) <= rm->cfg.voltage_down_V;
        if (!rm->voltage_down_candidate)
            rm->voltage_down_ms = 0;
    }
}

void smu_range_reassert(smu_range_manager_t* rm) {
    if (rm->tx_state == SMU_RANGE_TX_FAULT)
        return;
    if (range_is_valid(rm->active)) {
        rm->requested = rm->active;
        rm->tx_state = SMU_RANGE_TX_PENDING;
    }
    if (!rm->vpending)
        rm->vrequested = rm->vactive;
    rm->vpending = true;
    rm->measurement_valid = false;
    rm->servo_allowed = false;
    smu_measurement_set_range_transition(true);
}

bool smu_range_accept_frame(smu_range_manager_t* rm) {
    if (rm->tx_state == SMU_RANGE_TX_SETTLE) {
        if (rm->discard_left > 0u) {
            rm->discard_left--;
            return false;
        }
        rm->tx_state = SMU_RANGE_TX_IDLE;
        rm->measurement_valid = true;
        rm->servo_allowed = true;
        smu_measurement_set_range_transition(false);
    }
    return rm->tx_state != SMU_RANGE_TX_FAULT;
}

void smu_range_resume_measurement(smu_range_manager_t* rm) {
    if (rm->tx_state == SMU_RANGE_TX_FAULT)
        return;
    rm->tx_state = SMU_RANGE_TX_SETTLE;
    rm->discard_left = rm->cfg.resume_discard_frames;
    rm->measurement_valid = rm->servo_allowed = false;
    smu_measurement_set_range_transition(true);
    smu_measurement_reset_filters();
    reset_current_autorange(rm);
    reset_voltage_autorange(rm);
}

void smu_range_acquisition_gap(smu_range_manager_t* rm) {
    reset_current_autorange(rm);
    reset_voltage_autorange(rm);
}

void smu_range_update_current_overload(smu_range_manager_t* rm, int32_t code) {
    const float abs_A = fabsf(smu_measurement_current_from_code(code, rm->active));
    rm->overload = range_is_valid(rm->active) && (code >= ADC_CLIP_CODE || code <= -ADC_CLIP_CODE || abs_A > rm->cfg.current_overload_fraction * smu_current_range_fs_A(rm->active));
    smu_measurement_set_overload(rm->overload);
}

void smu_range_current_autorange_frame(smu_range_manager_t* rm, int32_t code, float filtered_A) {
    if (!range_is_valid(rm->active))
        return;

    const float fs = smu_current_range_fs_A(rm->active);
    const float abs_A = fabsf(smu_measurement_current_from_code(code, rm->active));
    const bool clipped = code >= ADC_CLIP_CODE || code <= -ADC_CLIP_CODE;
    const bool saturated = clipped || abs_A > rm->cfg.current_overload_fraction * fs;

    smu_range_update_current_overload(rm, code);

    if (!rm->current_autorange_enabled || rm->tx_state != SMU_RANGE_TX_IDLE)
        return;

    /* Up-range. A saturated reading says nothing about the real current, so
     * go straight to 1.5 A and let down-ranging find the right range;
     * otherwise jump to the smallest range that fits the reading. */
    if (rm->active != SMU_RANGE_1P5A && (clipped || abs_A > rm->cfg.current_up_fraction * fs)) {
        rm->current_down_candidate = false;
        rm->current_down_ms = 0;
        if (saturated) {
            (void)smu_range_request(rm, SMU_RANGE_1P5A, SMU_RANGE_REASON_OVERLOAD);
        } else if (++rm->current_up_count >= rm->cfg.current_up_confirm_frames) {
            smu_current_range_t t = smallest_fit(rm, abs_A);
            if (!is_smaller(rm->active, t))
                t = (smu_current_range_t)((int)rm->active - 1);
            (void)smu_range_request(rm, t, SMU_RANGE_REASON_AUTORANGE);
        }
        return;
    }
    rm->current_up_count = 0;

    /* Down-range candidate: some smaller range fits the filtered current.
     * Must hold for current_down_persist_ms (checked in tick). */
    rm->current_last_filtered_A = fabsf(filtered_A);
    rm->current_down_candidate = is_smaller(smallest_fit(rm, rm->current_last_filtered_A), rm->active);
    if (!rm->current_down_candidate)
        rm->current_down_ms = 0;
}

void smu_range_tick_ms(smu_range_manager_t* rm, uint32_t elapsed_ms) {
    if (rm->tx_state == SMU_RANGE_TX_FAULT)
        return;

    if (rm->pa_inhibited || safety_hw_pa_requested())
        rm->pa_off_wait_ms = rm->cfg.pa_off_settle_ms;
    else if (elapsed_ms >= rm->pa_off_wait_ms)
        rm->pa_off_wait_ms = 0;
    else
        rm->pa_off_wait_ms -= elapsed_ms;
    const bool connect = rm->input_10m_requested && !rm->pa_inhibited && !rm->pa_off_wait_ms && !safety_hw_pa_requested();
    rm->impedance_pending = connect != rm->input_10m_active;
    if (rm->tx_state == SMU_RANGE_TX_PENDING || (rm->tx_state == SMU_RANGE_TX_IDLE && (rm->vpending || rm->impedance_pending))) {
        apply_switch(rm);
        return;
    }

    if (elapsed_ms && rm->voltage_autorange_enabled && rm->tx_state == SMU_RANGE_TX_IDLE) {
        if (rm->voltage_frame_seen && rm->voltage_down_candidate && rm->vactive == SMU_VRANGE_15V) {
            if (rm->voltage_down_ms >= rm->cfg.voltage_down_persist_ms || elapsed_ms >= rm->cfg.voltage_down_persist_ms - rm->voltage_down_ms) {
                rm->voltage_down_ms = 0;
                (void)smu_range_request_voltage(rm, SMU_VRANGE_6V);
            } else
                rm->voltage_down_ms += elapsed_ms;
        } else
            rm->voltage_down_ms = 0;
        rm->voltage_frame_seen = false;
    }

    if (!rm->current_autorange_enabled || rm->tx_state != SMU_RANGE_TX_IDLE || !rm->current_down_candidate)
        return;

    rm->current_down_ms += elapsed_ms;
    if (rm->current_down_ms >= rm->cfg.current_down_persist_ms) {
        (void)smu_range_request(rm, smallest_fit(rm, rm->current_last_filtered_A), SMU_RANGE_REASON_AUTORANGE);
        reset_current_autorange(rm);
    }
}
