bodri/smuk/firmware/tests/test_fv.c

#include "smu.h"
#include "smu_fv.h"
#include "smu_fv_board.h"
#include "smu_fv_port.h"
#include <assert.h>
#include <math.h>
#include <stdio.h>
#include <string.h>
static smu_context_t ctx;
static smu_measurement_outputs_t measurement;
static uint32_t now;
static bool pa, relay, fail_write, fail_relay, available = true;
static uint16_t last_code;
static bool unipolar, installed_converter;
static float trim;

uint32_t smu_port_millis(void) {
    return now;
}

const smu_context_t* smu_get_context(void) {
    return &ctx;
}

void smu_get_measurement(smu_measurement_outputs_t* out) {
    *out = measurement;
}

void safety_hw_disable_pa(void) {
}

bool safety_hw_request_pa_enable(void) {
    return true;
}

bool smu_fv_port_init(smu_fv_config_t* c) {
    pa = relay = false;
    *c = (smu_fv_config_t){3.3f, 1.65f, 10.0f, -2.0f, 2.0f, 1.0f, true, false, false, 0.0f};
    if (unipolar)
        *c = (smu_fv_config_t){3.3f, 0.0f, 5.0f, 0.0f, 1.0f, 1.0f, false, true, true, 0.0f};
    if (installed_converter)
        *c = (smu_fv_config_t){SMU_FV_REFERENCE_V, SMU_FV_ZERO_DAC_V, SMU_FV_GAIN, SMU_FV_MIN_V, SMU_FV_MAX_V, SMU_FV_SLEW_V_S, SMU_FV_DAC_BUFFERED, SMU_FV_PA_ENABLE_STUB, SMU_FV_RELAY_STUB, trim};
    return available;
}

bool smu_fv_port_write(uint16_t code) {
    last_code = code;
    return !fail_write;
}

bool smu_fv_port_pa(bool enabled) {
    pa = enabled;
    return true;
}

bool smu_fv_port_relay(bool enabled) {
    if (!enabled)
        assert(!pa);
    relay = enabled;
    return !fail_relay;
}

static void boot(void) {
    available = true;
    fail_write = fail_relay = false;
    now = 0;
    memset(&ctx, 0, sizeof(ctx));
    memset(&measurement, 0, sizeof(measurement));
    ctx.state = SMU_STATE_NORMAL;
    ctx.range = SMU_RANGE_1P5A;
    ctx.vrange = SMU_VRANGE_15V;
    ctx.measurement_valid = ctx.measurement_fresh = ctx.measurement_settled = true;
    ctx.adc_rate_known = ctx.adc_rate_ok = true;
    smu_fv_init();
    assert(smu_fv_status()->state == SMU_FV_OFF && !pa && !relay);
    assert(last_code == 2048);
}

static void start(void) {
    assert(smu_fv_output(true) == SMU_OK && pa && !relay);
    now += 9;
    smu_fv_process();
    assert(!relay);
    now += 1;
    smu_fv_process();
    assert(relay);
    now += 10;
    smu_fv_process();
    assert(smu_fv_status()->state == SMU_FV_ACTIVE);
}

static void plant_tick(float gain, float offset) {
    ++now;
    measurement.sample_count++;
    measurement.precision_ready = true;
    measurement.precision.valid = measurement.precision.fresh = measurement.precision.settled = true;
    measurement.precision.range = ctx.range;
    measurement.precision.vrange = ctx.vrange;
    measurement.precision_window = 8;
    measurement.precision.voltage_V = (last_code * 3.3f / 4095.0f - 1.5f) * gain + offset;
    smu_fv_process();
}

int main(void) {
    boot();
    assert(smu_fv_set_voltage(NAN) == SMU_ERR_ARG);
    assert(smu_fv_set_voltage(2.01f) == SMU_ERR_ARG);
    ctx.current_autorange = true;
    assert(smu_fv_output(true) == SMU_ERR_STATE);
    ctx.current_autorange = false;
    ctx.input_10m_requested = true;
    assert(smu_fv_output(true) == SMU_ERR_STATE);
    ctx.input_10m_requested = false;
    ctx.adc_rate_known = false;
    assert(smu_fv_output(true) == SMU_ERR_STATE);
    ctx.adc_rate_known = true;
    ctx.range = SMU_RANGE_NONE;
    assert(smu_fv_output(true) == SMU_ERR_STATE);
    ctx.range = SMU_RANGE_1P5A;
    ctx.vrange = (smu_voltage_range_t)99;
    assert(smu_fv_output(true) == SMU_ERR_STATE);
    ctx.vrange = SMU_VRANGE_15V;
    assert(smu_fv_set_voltage(1.0f) == SMU_OK);
    start();
    now += 10;
    smu_fv_process();
    assert(fabsf(smu_fv_status()->applied_V - 0.01f) < 1e-6f);
    now += 1000;
    smu_fv_process();
    assert(fabsf(smu_fv_status()->applied_V - 0.02f) < 1e-6f);
    assert(smu_fv_output(false) == SMU_OK && !pa && !relay && smu_fv_status()->requested_V == 0);
    for (int range = SMU_RANGE_1P5A; range <= SMU_RANGE_100UA; ++range) {
        boot();
        ctx.range = (smu_current_range_t)range;
        assert(smu_fv_set_voltage(-0.5f) == SMU_OK);
        start();
        ++now;
        smu_fv_process();
        assert(smu_fv_status()->state == SMU_FV_ACTIVE);
        /* Any unexpected current range change must still trip the output. */
        ctx.range = range == SMU_RANGE_1P5A ? SMU_RANGE_100MA : SMU_RANGE_1P5A;
        ++now;
        smu_fv_process();
        assert(smu_fv_status()->state == SMU_FV_TRIPPED);
        assert(smu_fv_output(false) == SMU_OK);
    }
    for (unsigned reason = 0; reason < 7; ++reason) {
        boot();
        start();
        switch (reason) {
        case 0:
            ctx.acquisition_stale = true;
            break;
        case 1:
            ctx.faults = SMU_FAULT_ADC;
            break;
        case 2:
            ctx.vrange = SMU_VRANGE_6V;
            break;
        case 3:
            ctx.input_10m_active = true;
            break;
        case 4:
            measurement.fast.current_A = NAN;
            break;
        case 5:
            measurement.fast.overload = true;
            break;
        case 6:
            fail_write = true;
            now += 1;
            break;
        }
        ++now;
        smu_fv_process();
        assert(smu_fv_status()->state == SMU_FV_TRIPPED && !pa && !relay);
        assert(smu_fv_output(true) == SMU_ERR_STATE);
        fail_write = false;
        assert(smu_fv_output(false) == SMU_OK);
    }
    boot();
    fail_relay = true;
    assert(smu_fv_output(true) == SMU_OK);
    now += 10;
    smu_fv_process();
    assert(smu_fv_status()->state == SMU_FV_TRIPPED && !pa && !relay);
    boot();
    start();
    smu_fv_trip();
    assert(!pa && !relay);
    boot();
    available = false;
    smu_fv_init();
    assert(smu_fv_status()->state == SMU_FV_UNAVAILABLE);
    assert(smu_fv_output(true) == SMU_ERR_HW);
    assert(smu_fv_set_voltage(0) == SMU_ERR_HW);
    boot();
    now = UINT32_MAX - 5;
    start();
    assert(smu_fv_output(false) == SMU_OK);
    unipolar = true;
    smu_fv_init();
    assert(smu_fv_status()->state == SMU_FV_OFF && last_code == 0);
    assert(smu_fv_set_voltage(-0.01f) == SMU_ERR_ARG);
    assert(smu_fv_set_voltage(0.5f) == SMU_OK);
    start();
    now += 10;
    smu_fv_process();
    assert(last_code == (uint16_t)lroundf((smu_fv_status()->applied_V / 5.0f) * 4095.0f / 3.3f));
    assert(last_code > 0 && smu_fv_status()->applied_V > 0);
    assert(smu_fv_output(false) == SMU_OK && last_code == 0);
    assert(smu_fv_status()->pa_always_enabled);
    assert(smu_fv_set_voltage(0.5f) == SMU_OK);
    start();
    now += 10;
    smu_fv_process();
    assert(last_code > 0);
    smu_fv_trip();
    assert(last_code == 0 && smu_fv_status()->state == SMU_FV_TRIPPED);
    installed_converter = true;
    smu_fv_init();
    assert(smu_fv_status()->state == SMU_FV_OFF && last_code == 1861);
    assert(smu_fv_status()->minimum_V == -15.0f && smu_fv_status()->maximum_V == 15.0f);
    assert(smu_fv_set_voltage(-15.001f) == SMU_ERR_ARG);
    assert(smu_fv_set_voltage(15.001f) == SMU_ERR_ARG);
    const float targets[] = {-15.0f, 15.0f, -1.0f, 1.0f};
    const uint16_t expected_codes[] = {0, 3723, 1737, 1985};
    for (unsigned target = 0; target < 4; ++target) {
        assert(smu_fv_set_voltage(targets[target]) == SMU_OK);
        start();
        for (unsigned tick = 0; tick < 1600; ++tick) {
            ++now;
            smu_fv_process();
            if (tick == 499)
                assert(fabsf(smu_fv_status()->applied_V - copysignf(fminf(5.0f, fabsf(targets[target])), targets[target])) < 0.001f);
        }
        assert(smu_fv_status()->state == SMU_FV_ACTIVE);
        assert(fabsf(smu_fv_status()->applied_V - targets[target]) < 1e-6f);
        assert(last_code == expected_codes[target]);
        assert(smu_fv_output(false) == SMU_OK && last_code == 1861);
    }
    assert(smu_fv_set_voltage(15.0f) == SMU_OK);
    start();
    for (unsigned tick = 0; tick < 1600; ++tick) {
        ++now;
        smu_fv_process();
    }
    assert(last_code == 3723);
    assert(smu_fv_set_voltage(-15.0f) == SMU_OK);
    for (unsigned tick = 0; tick < 3100; ++tick) {
        ++now;
        smu_fv_process();
        if (tick == 1499)
            assert(fabsf(smu_fv_status()->applied_V) < 0.001f);
    }
    assert(last_code == 0 && smu_fv_status()->state == SMU_FV_ACTIVE);
    assert(smu_fv_output(false) == SMU_OK && last_code == 1861);
    assert(smu_fv_set_voltage(-0.5f) == SMU_OK);
    start();
    now += 10;
    smu_fv_process();
    assert(last_code <= 1861);
    smu_fv_trip();
    assert(last_code == 1861 && smu_fv_status()->state == SMU_FV_TRIPPED);
    trim = 0.052f;
    assert(SMU_FV_ZERO_OFFSET_V == 0.0f);
    smu_fv_init();
    assert(smu_fv_status()->state == SMU_FV_OFF && last_code == 1855);
    assert(smu_fv_status()->minimum_V > -15.0f);
    assert(fabsf(smu_fv_status()->minimum_V - (-14.948f)) < 0.0001f);
    assert(smu_fv_set_voltage(-15.0f) == SMU_ERR_ARG);
    assert(smu_fv_set_voltage(smu_fv_status()->minimum_V) == SMU_OK);
    assert(smu_fv_set_voltage(0.5f) == SMU_OK);
    start();
    now += 10;
    smu_fv_process();
    assert(smu_fv_output(false) == SMU_OK && last_code == 1855);
    assert(smu_fv_set_voltage(-0.5f) == SMU_OK);
    start();
    now += 10;
    smu_fv_process();
    smu_fv_trip();
    assert(last_code == 1855);
    assert(smu_fv_output(false) == SMU_OK);
    ctx.vrange = SMU_VRANGE_6V;
    assert(fabsf(smu_fv_status()->maximum_V - 6.0f) < 0.0001f);
    assert(fabsf(smu_fv_status()->minimum_V + 5.9792f) < 0.0001f);
    assert(smu_fv_set_voltage(6.001f) == SMU_ERR_ARG);
    assert(smu_fv_set_voltage(-6.0f) == SMU_ERR_ARG);
    assert(smu_fv_set_voltage(1.0f) == SMU_OK);
    start();
    for (unsigned i = 0; i < 100; ++i) {
        ++now;
        smu_fv_process();
    }
    assert(fabsf(smu_fv_status()->applied_V - 1.0f) < 0.0001f);
    assert(last_code == 2165); /* 1.4948 + 1 / 4 V at DAC. */
    assert(smu_fv_output(false) == SMU_OK && last_code == 1855);
    assert(smu_fv_set_voltage(-1.0f) == SMU_OK);
    start();
    for (unsigned i = 0; i < 100; ++i) {
        ++now;
        smu_fv_process();
    }
    assert(last_code == 1545); /* 1.4948 - 1 / 4 V at DAC. */
    assert(smu_fv_output(false) == SMU_OK && last_code == 1855);
    ctx.vrange = SMU_VRANGE_15V;
    assert(fabsf(smu_fv_status()->maximum_V - 15.0f) < 0.0001f);
    assert(smu_fv_status()->requested_V == 0.0f);
    trim = -0.052f;
    smu_fv_init();
    assert(smu_fv_status()->state == SMU_FV_OFF && last_code == 1868);
    trim = 0;
    memset(&measurement, 0, sizeof(measurement));
    smu_fv_init();
    assert(!smu_fv_status()->zero_valid && !smu_fv_status()->regulation);
    assert(smu_fv_zero() == SMU_OK);
    assert(smu_fv_set_voltage(1) == SMU_ERR_STATE);
    assert(smu_fv_output(true) == SMU_ERR_STATE);
    for (unsigned i = 0; i < 8000; ++i)
        plant_tick(10, 0.052f);
    assert(smu_fv_status()->state == SMU_FV_OFF && smu_fv_status()->zero_valid);
    assert(fabsf(measurement.precision.voltage_V) < 0.006f);
    const uint16_t learned_code = last_code;
    assert(smu_fv_regulation(true) == SMU_OK);
    assert(smu_fv_set_voltage(1) == SMU_OK);
    start();
    /* Simulate an additional source-path gain error. */
    for (unsigned i = 0; i < 5000; ++i)
        plant_tick(9.8f, 0.052f);
    assert(fabsf(measurement.precision.voltage_V - 1) < 0.006f);
    assert(smu_fv_status()->correction_V > 0);
    /* Above the former 10 mA trip and 8 mA correction cutoff, both signs
     * remain active and correction continues without reported compliance. */
    for (unsigned sign = 0; sign < 2; ++sign) {
        measurement.fast.current_A = sign ? -0.02f : 0.02f;
        for (unsigned i = 0; i < 4000; ++i)
            plant_tick(sign ? 9.7f : 9.6f, 0.052f);
        assert(smu_fv_status()->state == SMU_FV_ACTIVE);
        assert(!smu_fv_status()->limited);
        assert(fabsf(measurement.precision.voltage_V - 1) < 0.006f);
    }
    measurement.fast.current_A = 0;
    const uint16_t regulated_code = last_code;
    /* A repeated precision sample must not accumulate any correction. */
    for (unsigned i = 0; i < 500; ++i) {
        ++now;
        smu_fv_process();
    }
    assert(last_code == regulated_code);
    measurement.precision.compliance = true;
    for (unsigned i = 0; i < 500; ++i)
        plant_tick(8, 0.052f);
    assert(last_code == regulated_code && smu_fv_status()->limited);
    measurement.precision.compliance = false;
    assert(smu_fv_output(false) == SMU_OK && last_code == learned_code);
    assert(smu_fv_set_voltage(-1) == SMU_OK);
    start();
    for (unsigned i = 0; i < 5000; ++i)
        plant_tick(9.8f, 0.052f);
    assert(fabsf(measurement.precision.voltage_V + 1) < 0.006f);
    for (unsigned i = 0; i < 10000; ++i)
        plant_tick(1, 0.052f); /* Unreachable target: bounded, no windup. */
    assert(smu_fv_status()->limited && fabsf(smu_fv_status()->correction_V) <= 0.2f);
    assert(smu_fv_output(false) == SMU_OK && last_code == learned_code);
    ctx.vrange = SMU_VRANGE_6V;
    assert(!smu_fv_status()->zero_valid);
    assert(smu_fv_zero() == SMU_OK);
    for (unsigned i = 0; i < 8000; ++i)
        plant_tick(4, 0.0208f);
    assert(smu_fv_status()->state == SMU_FV_OFF && smu_fv_status()->zero_valid);
    assert(fabsf(measurement.precision.voltage_V) < 0.003f);
    ctx.vrange = SMU_VRANGE_15V;
    assert(smu_fv_status()->zero_valid && last_code == learned_code);
    assert(smu_fv_zero() == SMU_OK);
    /* Large external voltage must not be learned as a source offset. */
    for (unsigned i = 0; i < 500; ++i)
        plant_tick(10, 1.0f);
    assert(smu_fv_status()->state == SMU_FV_TRIPPED);
    assert(last_code == learned_code);
    assert(smu_fv_output(false) == SMU_OK);
    assert(smu_fv_zero() == SMU_OK);
    assert(smu_fv_output(false) == SMU_OK); /* Explicit cancellation. */
    assert(smu_fv_status()->state == SMU_FV_OFF && last_code == learned_code);
    assert(smu_fv_zero() == SMU_OK);
    measurement.precision_ready = false;
    now += 60001;
    smu_fv_process();
    assert(smu_fv_status()->state == SMU_FV_TRIPPED && last_code == learned_code);
    trim = NAN;
    smu_fv_init();
    assert(smu_fv_status()->state == SMU_FV_UNAVAILABLE);
    puts("FV sequencing, limits, slew, unavailable hardware and fault shutdown passed.");
}
