bodri/smuk/(commit log)

2026-10-01 Refactor ADS131M03 driver: - consolidate all code into one place - create the HAL agnostic implementaion
2026-10-01 Oops, this was missing
    [ads131m03_port_hal.c]
2026-10-01 - Calibration discard/acquisition phases now have configurable 1-second timeouts, accounting for elapsed time and running cleanup immediately when a timeout is detected.
    - Applying coefficients preserves measurement ranges, flags, counters,
    and filter settings. Filter history resets to avoid mixing values from
    different calibrations.
    [main.c, smu_cal_seq.c, smu_cal_seq.h, smu_calibration.c, smu_measurement.c, smu_measurement.h, test_calibration_state.c]
2026-10-01 Updated build.sh: clang-format and cppcheck now include Platform, Drivers/SMU, and Storage alongside Core. README coverage is updated too.
2026-10-01 - Moved smu_cal_seq, smu_calibration, smu_measurement (.c/.h) from Drivers/SMU/ to App/ via git mv. - App/smu_calibration.h: tidied #include "../Storage/calibration_store.h" → #include "calibration_s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
2026-10-01 Moving some calibration code from main to smu_calibration
2026-10-01 Refactor: smu is now the top level, all of App/ is compiled, and current autorange runs on the ADC frame stream.
2026-10-01 Set the correct pin level for vrange and current ranges after boot
    [main.c, smuk.ioc]
2026-10-02 Add console support and make calibration easy
2026-10-02 Implement autorange for voltage measurement
2026-10-02 - Default 10 MΩ input after initialization. - IMPEDANCE 10M / IMPEDANCE HIGHZ commands. - STATUS? reports requested and applied impedance. - Changes reset filters and discard 40 settling frames. - Ca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
    [range_hw.c, range_hw.h, range_hw_port.h, range_hw_port_hal.c, safety_hw.c, safety_hw.h, smu.c, smu.h]
2026-10-02 - Cached validity and quality flags update immediately. - Separate current, voltage, and CALBUS clipping flags; overloaded I/V samples are excluded from filters. - Acquisition gaps reset history and 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
    [smu.c, smu.h, smu_cal_debug.c, smu_cal_debug.h, smu_cal_seq.c, smu_cal_seq.h, smu_console.c, smu_console.h]
2026-10-02 - Full-window precision validity, stable averaging, and selectable INTEGRATION 1MS|8MS|20MS|50MS|100MS. - Calibration coefficient validation, noise/drift/span checks, residual reporting, and Flash/de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
    [calibration_record.c, calibration_store.c, calibration_store.h, smu.c, smu.h, smu_acquisition.c, smu_acquisition.h, smu_cal_capture.c]
2026-10-02 Implemented the nominal 2-second IWDG, foreground-only refresh, debug freeze, and reset reporting through STATUS?.
    [main.c, smu.c, smu_console.c, smu_watchdog.c, smu_watchdog.h, smu_watchdog_port.h, smu_watchdog_port_hal.c]
2026-10-03 Implement guided manual calibration workflow.
2026-10-03 Fix misconfigured switch for 100mA current range
    [main.h, smuk.ioc]
2026-10-04 Change ADC acqusition speed to 32ksps
2026-10-04 Integration options: 500 µs, 1, 2, 5, 8, 10, 20, 50, 100 ms. 2 ms default at startup—64 raw samples at 32 kSPS.
2026-10-14 Add HAL-agnostic FV controller and an STM32H503 DAC1/channel-2 backend
2026-10-15 Add +/-3V converter and implement the full output voltage range in 15V
2026-10-15 Implemented support for both 6 V and 15 V ranges.
2026-10-17 PA output voltage measurement concept
2026-10-22 Remove some current related limitation for FV
2026-11-12 New PCB design
